Jackcdut/Graduation-project-ESP32/毕业论文/图/IMG_20251211_115416.png

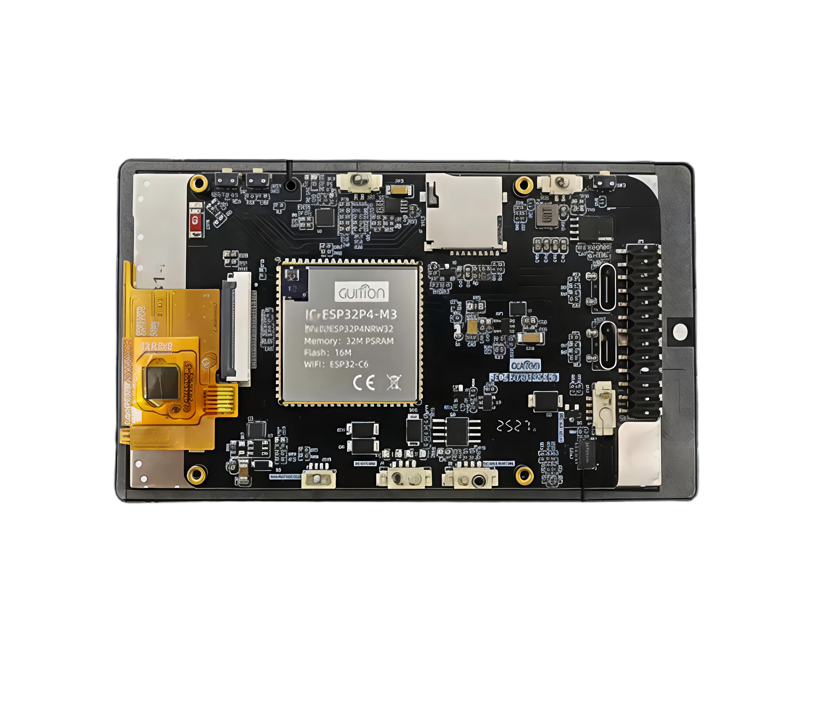
毕业论文/图/IMG_20251211_115416.png
