Jackcdut/Graduation-project-ESP32/毕业论文/图/tb_image_share_1765424619179.jpg.png

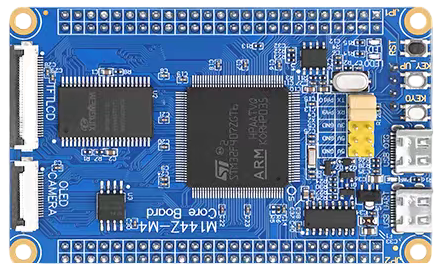
毕业论文/图/tb_image_share_1765424619179.jpg.png
