Jackcdut/Graduation-project-ESP32/毕业论文/开题/202206010320 纪帅.pdf

## 成 都 理 工 大 学

## 学生毕业设计（论文）开题报告

题目名称：面向开发调试的一体化便携测试系统设计

（中英文） Design of an Integrated Portable Testing System for Development and Debugging

题目类型：开发与设计

题目来源：教师拟定

学生姓名：纪帅 | 学生学号：202206010320 | 专业名称： 测控技术与仪器
导师姓名：司绍博 | 专业职称：研究员 | 指导人数：5

①主要研究内容、预期成果（鼓励有创新点）

### 一、 主要研究内容

本研究将遵循从系统顶层至功能模块、从硬件底层至软件应用、从本地功能至云 端协同的全栈研发路径，系统性地开展以下三个核心研究内容。

### 1.1 电路控制与信号处理（STM32 端）

本部分是整个系统的物理基础与控制核心。需要完成关键功能模块的电路与驱动 设计，实现±36V 电压的采集；基于直接数字频率合成（DDS）技术的信号发生方案， 完成 AD983x 系列芯片的外围电路设计与 SPI 驱动开发，实现 1Hz-1MHz 可编程波形 输出；研究数控开关电源原理，设计以 DAC 控制电路为核心、集成 PID 反馈的电源 模块，实现 0-12V/2A 的稳定可调输出等等。

### 1.2 数据通信与人机交互（STM32 与 ESP32）

核心在于设计一套轻量级、高可靠的通信协议。针对波形数据（数据量大、实时 性要求高）、参数指令（数据量小、要求可靠）等不同类型的信息传输需求，研究并 制定一套串行应用层协议。该协议需定义完整的帧结构（包括帧头、类型标识、长度、 数据载荷及 CRC 校验）以确保在复杂的电磁环境下数据能准确、有序地传输。在此基 础上，实现测量数据的实时图形化显示。在 ESP32 端，研究 LVGL 图形库的驱动与资 源管理，设计并实现包含波形显示区、参数读数区及虚拟控制面板的一体化用户界面。 编写专门的通信任务，实时解析来自 STM32 的协议数据包，并驱动 LVGL 的图表控 件动态刷新波形，更新数值标签等丰富完善的功能。

### 1.3 网络集成与云端服务（ESP32 端）

为系统赋予物联网能力，扩展其从本地工具到远程节点的应用边界，实现数据的 聚合与价值提升。重点实现设备与云平台的安全接入和数据上行。研究 ESP32 的 Wi-Fi 网络连接管理与中国移动 OneNet 云平台的设备接入规范。集成 MQTT 客户端，编 写网络任务，将 STM32 上传的经过预处理的数据（如波形特征值、仪表读数、设备状

态）封装为标准 JSON 格式，上传至云平台对应的数据流，完成从设备端到云端的“最 后一公里”接入。进而，开发云端数据服务与远程交互界面。同时，作为高级应用，开 发构建一个基于 HTML5 与 JavaScript 的实时数据网页。该网页通过订阅设备数据， 能够查看波形、查询历史记录、信号分析（噪声滤波，信号变换，数据导出）等功能， 初步实现系统的“端-云-端”远程协同调试能力。

### 二、 预期成果

- 功能集成测试系统平台：完成一款集示波器、信号发生器、数控直流电源、数 字万用表、无线串口五大核心功能于一体的实体设备。并设计实现包含主控、信号调 理、功率转换、接口等模块的完整电路原理图设计与四层 PCB 绘制、打样及焊接装 配，并与 ESP32-P4 核心板及 4.3 寸 MIPI 显示屏实现叠层集成。此外，完成配套外壳 的结构设计与绘制，实现系统的整体封装与便携化。
- 完整的毕业设计论文（设计报告）：系统阐述项目的背景意义、国内外现状、 详细的设计与实现过程（包括硬件电路设计、软件架构、算法原理、通信协议等）、 系统测试方法与结果分析、总结与展望。
②拟采用的研究思路（研究方法、技术路线、可行性论证）

### 三、 研究方法

### 3.1 理论基础与关键技术分析

### 3.1.1 直接数字频率合成（DDS）

在信号发生器电路中，使用 DDS 实现频率可调波形的产生。DDS（Direct Digital Frequency Synthesis，直接数字频率合成）是一种基于数字控制的信号生成技术，在通 信、雷达、仪器仪表及音频合成等领域广泛应用。其核心优势在于能够以高精度和快 速响应能力，生成频率与相位均可编程的信号。具体工作原理为：通过数字方式控制 相位累加器，从而在每个时钟周期内生成一个相位值，再通过查找表（LUT）将相位 值转换为对应的幅度值，最后通过 DAC（数模转换器）输出模拟信号。主要组成结构 见下图 3-1 所示。

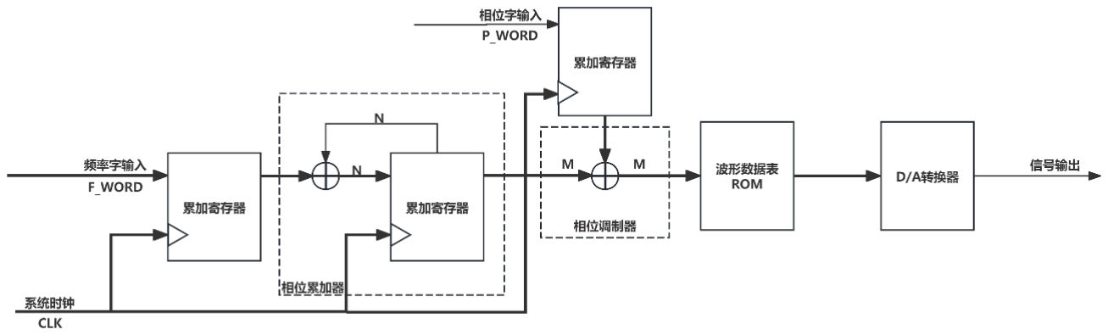
[picture p5: figure]

图 3-1 DDS 发生器基本结构框图

### 3.1.2 三重 ADC 交替采样

在示波器电路设计中，若直接采用微控制器（MCU）片内集成的模数转换器（ADC） 进行信号采样，其最高采样率通常受限于 ADC 模块自身的时钟频率与转换周期，难 以满足对高频信号的捕捉需求。为在有限的硬件成本下有效提升系统的等效采样率， 采用三重 ADC 交替采样，其原理是：当采样过程启动后，ADC1 首先执行采样操作。 经过数个 ADC 时钟周期的固定延时，ADC2 开始对同一通道进行采样，此时 ADC1 已 进入数据转换阶段。同理，在 ADC2 采样完成并再延时数个时钟周期后，ADC3 启动 采样，此时 ADC1 与 ADC2 均处于数据转换阶段。理想情况下，当 ADC3 完成采样 时，ADC1 的转换也已结束。如此，最大限度地利用硬件资源，在不提高单个 ADC 时 钟频率的前提下，将系统的整体采样吞吐量提升至近三倍。 本设计下位机部分对于信号处理使用 STM32F407ZGT6 作为控制单元，参考其数 据手册中的描述：在 ADC1、ADC2 或 ADC3 转换事件结束时，会生成三个 32 位 DMA 传输请求。之后会发生三次从 ADC_CDR 32 位寄存器到 SRAM 的传输：首先传输 ADC1 转换数据，然后是 ADC2 转换数据，最后是 ADC3 转换数据。每次出现新的三 阶段转换时都会重复这 1 一过程。当 ADC1/ADC2/ADC3 的规则通道全部完成转换后， 会生成一个 EOC 中断。整个 ADC 采样转换过程见下图 3-2 所示。

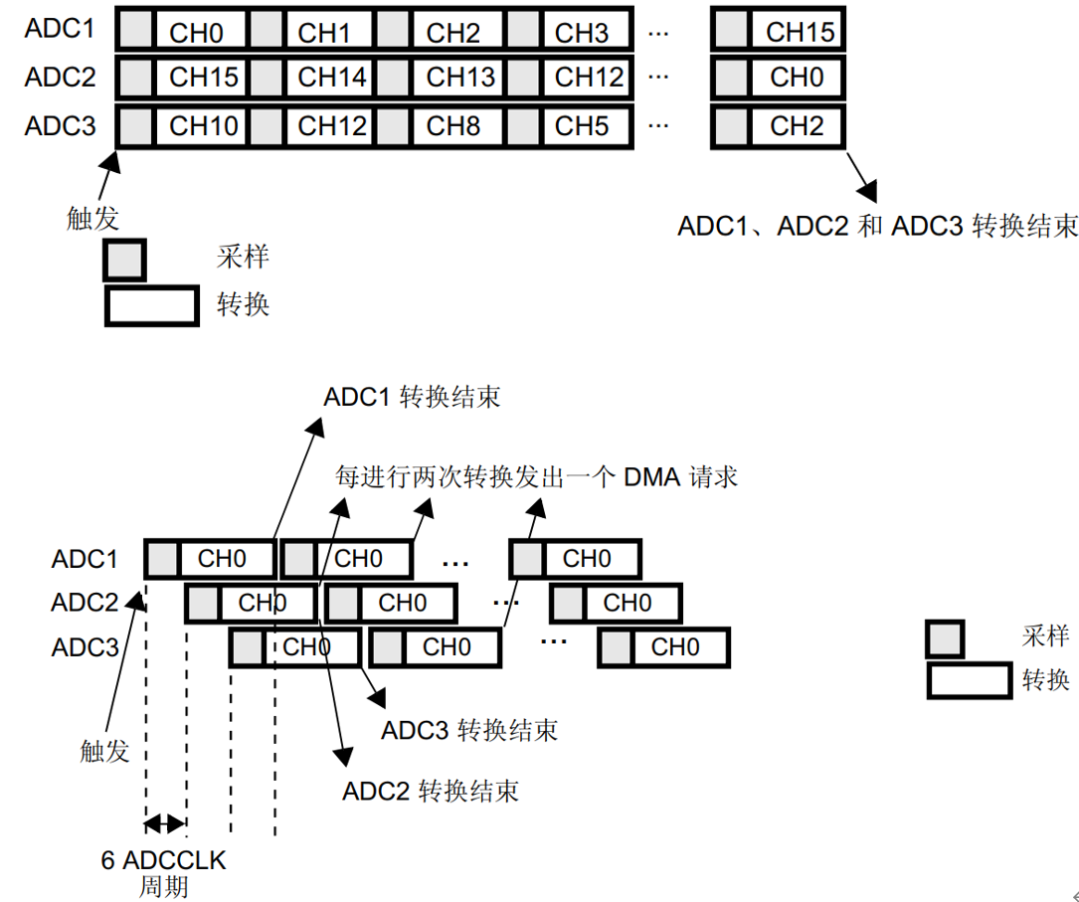
[picture p6: figure]

图 3-2 三重 ADC 模式
根据上图 3-2 可知，每当出现 2 个可用数据项时，就会生成一个 DMA 传输请求。 DMA 传输的具体顺序如下：

第 1 个请求：ADC_CDR[31:0] = ADC2_DR[15:0] | ADC1_DR[15:0]
第 2 个请求：ADC_CDR[31:0] = ADC1_DR[15:0] | ADC3_DR[15:0]
第 3 个请求：ADC_CDR[31:0] = ADC3_DR[15:0] | ADC2_DR[15:0]
第 4 个请求：ADC_CDR[31:0] = ADC2_DR[15:0] | ADC1_DR[15:0]……
因此，根据计算，ADC 完成一次转换所需的总时间Tconv 为
Tconv = Tsampling + Tconversion | (3 − 1)

采样率就是Tconv 的倒数 1

Tconv

。其中，Tsampling（采样时间）：ADC 内部采样电容对输入信号

进行充电保持所需的时间。以 ADC 时钟周期为单位，记为 SMPx 位（例如，3 周期、15 周期、

480 周期等）。时间越长，精度越高。Tconversion（转换时间）：将采样到的模拟值转换为数字值

所需的时间。对于 STM32F407ZGT6 的 12 位 ADC，固定为 12 个 ADC 时钟周期。
因此，最终采样率公式为：

fs single =

fADCCLK
SMPx + 12

(3 − 2)

以 STM32F407ZGT6 为例，ADC 最大时钟频率为 36MHz，采样时间选择最短 SMPx = 3。计算出理论最大采样率为 2.4MSPS。而通过采用三重 ADC 交替采样模式， 可使得理论最大采样率达 7.2MSPS，大大提高系统性能。

### 3.1.3 基于 DAC 与双环反馈的恒流恒压控制

在数控电源电路中，为实现对输出电压与电流的精确、稳定控制，并确保电源与 负载的安全，需在控制环路中构建独立的电压与电流双闭环反馈。通过 DAC 设定电 压与电流的参考基准，系统可依据负载实时状态在恒压与恒流模式间自动切换：当负 载电流低于设定限值时，电压环起主导作用，电源工作于恒压模式；一旦负载加重或 发生短路，电流达到设定限值，控制权自动平滑切换至电流环，电源转入恒流保护模 式。这种方式设计简洁，无需依赖传统笨重的电位器与分压网络，便于集成在系统中。 具体工作原理为：通过 DAC 设定目标值，反馈电路实时采样输出并与设定值比 较，通过误差放大器控制功率级，并由“电压环”和“电流环”两个控制环路通过“二极管 或门”或模拟开关自动竞争，实现工作模式切换。相应的工作示意图见下图 2-3 所示。

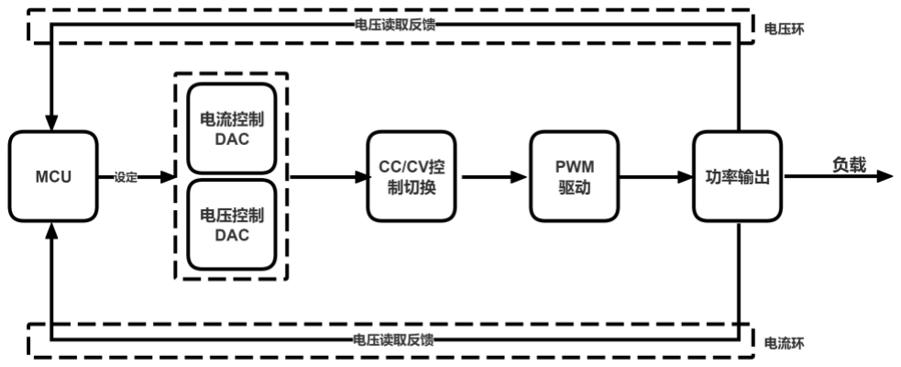
[picture p7: figure]

图 3-3 电流环与电压环反馈的恒流恒压电路框图

在恒压（CV）模式中，目标是稳定输出电压等于设定电压。反馈电压与设定电压 在电压误差放大器中进行比较。如果反馈电压小于设定电压，那么实际电压输出升高， 驱动功率级增加输出，使 反馈电压上升，直至等于设定电压，系统达到平衡。此时电 流环的状态：在纯负载（电阻）下，输出电流由设定电压和负载电阻大小决定。只要 输出电流小于设定电流，电流采样值反馈电流就小于设定电流，电流误差放大器会输 出一个很高的电压（试图拉满电流），但由于后级控制电路，会被电压环的较低输出 所“阻塞”，无法控制功率级，因此此时电流环处于“饱和”或“待命”状态。 在恒流（CC）模式中，目标是稳定输出电流等于设定电流。当负载减小时，输出 电流试图增大。一旦输出电流达到设定电流，反馈电流便等于设定电流。如果负载持 续减小，输出电流就将会超过设定电流，导致反馈电流将大于设定电流。此时，电流 误差放大器开始动作，其输出电压降低，通过后级控制电路抢过控制权，迫使功率级 降低输出电压，让输出电流精确维持在设定电流。此时电压环的状态：由于输出电压 因限流而下降，反馈电压会低于设定电压，电压误差放大器会输出一个很高的电压（试 图升压），但同样被电流环的较低输出所“阻塞”。因此此时电压环处于“饱和”或“待命” 状态。

### 3.1.4 OneNet 云平台的 HTTP API 集成

为实现一体化测试系统的远程数据管理与协同调试功能，本设计选用中国移动 OneNet 物联网云平台作为云端支撑。该平台提供设备管理、数据存储与可视化等 PaaS 服务，支持包括 HTTP、MQTT 在内的多种协议接入。 传统物联网设备接入流程通常要求用户在云端平台手动创建设备、配置鉴权信 息，步骤繁琐且影响用户体验。为此，本设计提出一种基于 HTTP 协议的设备自动注 册与接入方案。设备首次上电联网后，可自动通过 HTTP 请求完成云端注册、认证并 建立连接，实现“即用即连”的便捷体验。该方案充分利用 HTTP 协议通用性强、易于 实现文件传输（如 multipart/form-data 格式）的特点，能够直接将示波器波形、系统日 志等调试数据以文件形式上传至云端存储，为后续远程调测与分析提供便利。 HTTP 协议采用经典的“请求–响应”模型，客户端通过结构化请求指明操作与资 源，服务器返回状态信息与结果内容。基于此，本系统可通过调用 OneNet 平台开放 的 RESTful API，实现数据上报、命令接收与文件管理等功能。未来还可进一步开发 Web 前端，通过相同 API 接口获取云端数据，实现基于浏览器的远程调试与数据分 析，从而构建从设备到云再到用户端的完整数据流，提升系统的可用性与调试效率。

### 3.1.5 LVGL 图形库

LVGL（Light and Versatile Graphics Library）是一款开源的嵌入式图形用户界面 库，专为资源受限的微控制器和嵌入式系统设计。该库采用 C 语言编写，具有高度可 移植性，支持多种显示控制器和输入设备，提供丰富的 GUI 控件（如按钮、标签、图 表、滑块、列表等）和现代化的视觉效果（包括抗锯齿渲染、透明度混合、动画过渡

等）。LVGL 的内存占用可低至 64KB Flash 和 8KB RAM，同时支持硬件加速以提升 渲染性能。本项目选择 LVGL 8.3 版本作为图形界面开发框架，主要基于以下考量：

LVGL 与 ESP-IDF 开发框架深度集成，乐鑫官方提供 esp_lvgl_port 适配层，可充分利

用 ESP32-P4 的 PPA（Pixel Processing Accelerator）硬件加速单元，实现高效的图形渲 染；同时 NXP 提供的 GUI Guider 可视化设计工具支持 LVGL 界面的拖拽式开发，能 够自动生成符合规范的 C 代码，提升复杂界面的开发效率；此外，LVGL 丰富的图表 控件可直接用于示波器波形显示和数据可视化，其事件驱动机制也便于实现触摸交互 功能。本设计计划基于 LVGL 官方提供的打印机工程 Demo 进行二次开发与功能完 善。该模板的主界面已集成时间显示模块与多级菜单按钮控件，具备良好的界面布局 与交互基础，便于后续功能的拓展与定制化设计。其主界面见下图所示。

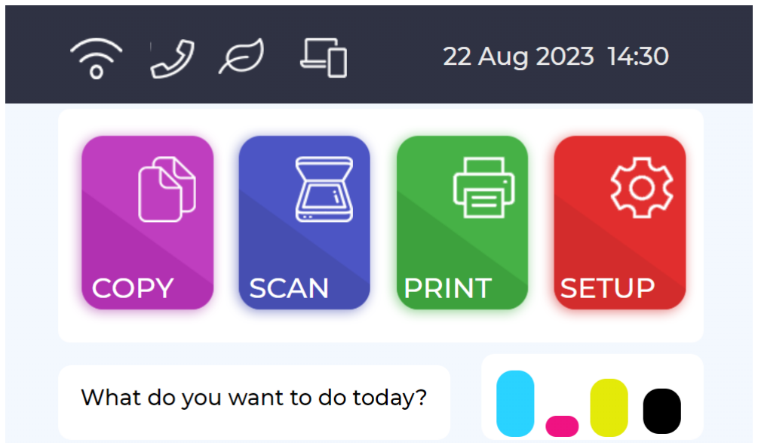
[picture p8: figure]

图 3-4 打印机 LVGL 主界面

### 3.2 研究思路与协同设计方法

总体设计遵循“功能模块化、控制集中化、交互图形化”的核心思想，构建以 ESP32-P4 与 STM32F407 双微处理器协同工作的硬件基础。其中，STM32F407 作为实时信号 处理单元，负责直接数字频率合成（DDS）波形产生、ADC 采样、数控电源反馈控制 等底层任务；ESP32-P4 则作为系统主控与交互处理器，依托其强大性能与内置无线模 块，用于运行 LVGL 图形用户界面、处理 Wi-Fi/4G 网络通信、实现与 OneNet 云平台 的数据交互。二者通过 UART 接口进行数据传输，并在 ESP32-P4 上搭载 FreeRTOS 实时操作系统，以多任务形式调度 GUI 刷新、网络通信、文件管理等顶层功能此外， 系统扩展集成 ESP32-C6 与 SD 卡模块，分别用于无线串口通信和本地数据存储，便 于调试并支持文件上传至 OneNet。预期该系统能够实现从信号发生、采集测量、电源 控制到本地显示、远程协同及数据存储等全功能一体化集成。系统的总体架构与各模 块间的逻辑关系如图 3-5 所示。

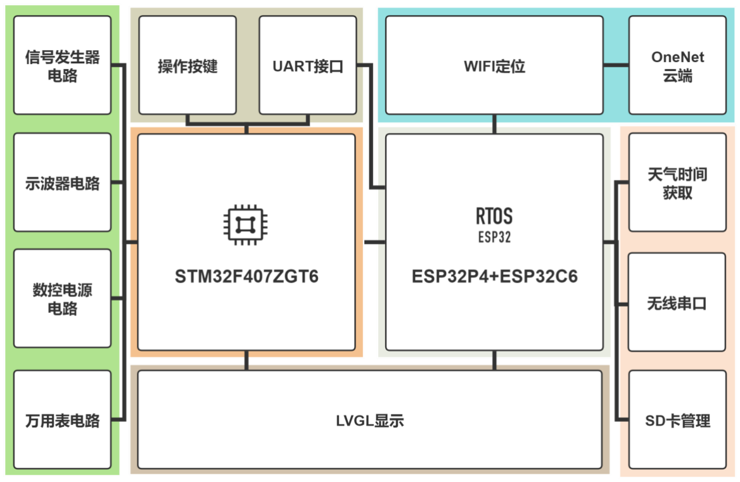
[picture p9: figure]

图 3-5 系统整体框图
在双核架构基础上，系统进一步采用 "数据驱动、功能解耦" 的设计方法构建系统 运行机制。各功能模块通过数据接口和状态机进行协同：
实时数据采集与处理路径：以示波器电路为例。示波器电路捕获的模拟信号经三 重 ADC 转换为数字数据，通过 DMA 传输至 STM32 内存区，经预处理后打包通过 UART 传送至 ESP32P4。ESP32P4 的显示任务将数据送入 LVGL 图表控件实时绘制波 形，同时网络任务可选择将数据文件通过 HTTP 协议上传至 OneNet 云端管理。 双向控制指令流：用户使用 LVGL 界面调整参数或控制命令，通过 UART 发送至 STM32F407。STM32 根据数据包内容，分别控制信号发生器的频率/幅值、数控电源 的设定输出电压/电流等，实现设备控制。
多源数据融合处理：系统集成 HTTP 天气获取、SD 卡存储等辅助功能。ESP32-C6 模块负责获取网络时间与天气数据，通过内部 SDIO 通信接口与 ESP32-P4 同步， 在 LVGL 界面统一显示；支持导出波形数据与测量结果并存储至 SD 卡，形成本地历 史记录，与云端存储构成互补的数据持久化。

### 四、 技术路线

### 4.1 总体技术路线规划

毕业设计技术路线总体规划见下图 4-1 所示。遵循“理论基础、模块验证、系统集 成、综合评估”的递进逻辑，系统展示从问题分析到方案验证的完整研究。

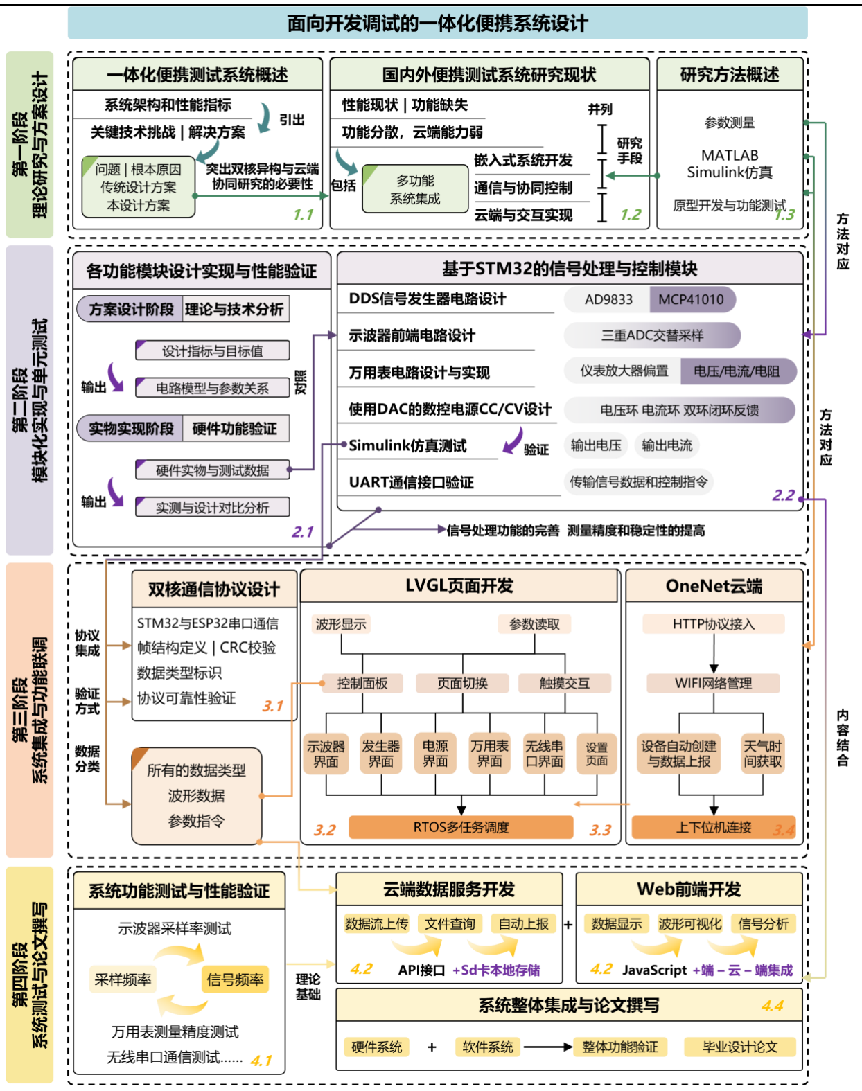
[picture p10: figure]

图 4-1 技术路线图
本设计分为四个阶段推进。第一阶段进行理论研究与方案设计，明确一体化便携 测试系统的架构与指标，分析现有问题并提出基于 STM32+ESP32 双核异构与 OneNet 云端协同的解决方案，同时调研国内外相关产品的优缺点。第二阶段开展模块化实现 与单元测试，完成硬件设计、四层 PCB 制作及核心模块（包括 DDS 信号发生器、示 波器前端、万用表电路和数控电源）的功能验证，通过仿真与测试提升测量精度与稳

定性。第三阶段实现系统集成与功能验证，设计双核通信协议，开发基于 LVGL 和 FreeRTOS 的多功能图形界面，并完成云端接入与上下位机联动。第四阶段进行系统 测试与论文撰写，验证各项性能指标，开发云端数据服务与 Web 前端，构建“端-云-端”整体架构，最终完成系统集成与毕业设计论文。

### 五、 可行性论证

### 5.1 技术可行性

### 5.1.1 理论扎实

系统设计所涉及的嵌入式软件架构、模拟/数字电路设计、信号处理算法及系统集 成等核心内容，与测控技术与仪器专业培养方案高度契合。本人已修毕《嵌入式系统 设计》、《传感器与检测技术》、《信号与系统》等核心专业课程，并取得优异成绩 （专业核心课平均成绩 88 分以上），建立扎实的理论基础。同时，通过课程设计、电 子竞赛等实践环节，积累 STM32、ESP32 等平台的开发经验，具备完成本毕业设计所 需的专业知识储备与工程实践能力。
信号发生器对应《信号与系统》、《数字信号处理》课程中的波形合成与频谱分 析理论，采用 AD9833 直接数字频率合成（DDS）技术，通过 28 位相位累加器实现 0.1Hz 的频率分辨率，结合 MCP41010 数字电位器实现幅值的程控调节，其工作原理 涉及采样定理、量化误差分析及数模转换等核心知识点，课程中对傅里叶变换、离散 时间信号处理的系统学习为理解 DDS 相位累加原理和频率合成机制奠定坚实基础。 示波器对应《模拟电子技术》、《电子测量技术》及《信号与系统》课程内容， 前端模拟信号调理电路涉及运算放大器、电压跟随器、衰减网络等模拟电路设计，负 电压产生电路采用电荷泵原理实现双电源供电，可编程增益放大通过模拟开关切换电 阻网络实现多档量程选择，这些设计直接应用课程中学习的反馈放大器、有源滤波器 及信号调理等理论知识；三重 ADC 交替采样实现 7.2MSPS 的高速数据采集，则运用 《数字信号处理》中的采样理论和抗混叠滤波原理。
万用表部分对应《传感器与检测技术》、《误差理论与数据处理》课程内容，电 压测量采用仪表放大器配合电阻分压网络实现±36V 宽量程输入，电阻测量基于电阻 分压原理通过四档 MOS 管切换实现 10Ω 至 1M 的多量程覆盖，电流测量利用精密采 样电阻将电流信号转换为电压信号进行检测，整个测量的精度分析、误差传递及校准 方法均源自课程中系统学习的测量不确定度评定和数据处理理论。 数控电源部分对应《自动控制原理》课程内容，采用恒压恒流（CV/CC）双环控 制策略应用经典控制理论中的 PI 调节器设计方法，电压外环和电流内环的参数整定、 稳定性分析及动态响应优化均基于课程中学习的频域分析和根轨迹法。 无线通信与人机交互模块的开发知识，主要来源于课外的系统性自主学习与实践 积累。作为一项四川省大学生创新训练计划项目的负责人，在主持开发“辐射探测腕

表”课题期间，本人已独立完成 LVGL 图形界面的架构设计、控件布局与交互逻辑实 现，积累嵌入式 GUI 开发的全流程经验。在此过程中，也熟练掌握借助 AI 辅助工具 进行界面原型设计、布局优化及代码生成的现代开发方法，能够高效、高质量地完成 复杂交互界面的开发任务。

### 5.1.2 系统架构可行

系统采用"STM32 实时采集处理+ESP32 应用交互显示"的双核异构架构，该架构 模式在工业测控领域已得到广泛验证和应用，能够有效平衡实时性要求与复杂应用逻 辑之间的矛盾。STM32F407 用于高速 ADC 采样、DDS 波形生成、电源环路控制等对 时序要求严格的任务，ESP32-P4 则负责 LVGL 图形界面渲染、触摸交互响应、WiFi 网络通信及云平台数据同步等应用任务。双核之间通过多路 UART 串口实现通信，每 个功能模块（示波器、信号发生器、万用表、数控电源）独立分配通信通道，避免数 据拥塞和相互干扰。通信协议采用统一的帧结构设计，包含帧头标识、命令字、数据 长度、有效载荷及 CRC 校验码，确保数据传输的完整性和可靠性。这种软硬件解耦的 分层架构使得各模块可独立开发调试，也便于后期功能扩展和维护升级。

### 5.2 开发条件可行性

项目开发所需的软硬件工具链完整齐备，开发环境成熟可靠。软件开发平台方面， STM32 端采用 Keil MDK 集成开发环境进行固件编写与调试，ESP32 端基于乐鑫官方 ESP-IDF 框架进行应用开发；电路设计采用嘉立创 EDA 完成原理图绘制与 PCB 布局 布线；系统仿真借助 MATLAB/Simulink 进行控制算法验证。上述软件工具均为现有 配置或开源免费获取，无额外成本投入。硬件测试条件方面，具备正点原子 DS100 数 字存储示波器、数控电源等测试仪器，能够满足从单元电路调试到系统级性能验证的 完整测试需求。

### 5.3 实施可行性

### 5.3.1 技术路线清晰

技术路线规划采用"四阶段"递进式研究路径：第一阶段聚焦理论研究与方案设计， 完成系统需求分析、总体架构设计及关键技术预研；第二阶段进行模块化实现与单元 测试，分别完成信号发生器、示波器、万用表、数控电源等各功能模块的硬件电路设 计与固件开发；第三阶段开展系统集成与功能验证，实现双核通信协议对接、人机交 互界面开发及云平台接入调试；第四阶段执行系统测试与论文撰写，完成性能指标测 试、可靠性验证及设计文档整理。各阶段逻辑衔接紧密、目标边界清晰，且均设置可 量化的阶段性成果输出，如设计说明书、原理图文件、测试报告等，便于进度跟踪与 质量把控。

### 5.3.2 模块化设计

系统采用模块化设计分散开发风险。硬件层面，信号发生器电路、示波器前端调 理电路、万用表测量电路、数控电源电路等各功能单元独立设计、独立供电，模块间 通过标准接口互联，单个模块的设计缺陷或调试问题不会影响其他模块的并行开发。 软件层面，采用分层架构组织代码结构，底层驱动层封装硬件操作接口，中间协议层 实现双核通信与数据解析，上层应用层负责业务逻辑与界面交互，各层职责明确、接 口规范，便于问题定位与快速迭代，同时也为后期功能扩展和性能优化预留充足空间。

### 5.4 时间可行性

### 5.4.1 时间安排合理

项目总周期规划为 16 周，与毕业设计时间安排高度匹配。工作计划已细化至周 期，各阶段任务分配均衡合理：理论研究与方案设计阶段约 3 周，模块化硬件实现与 单元测试阶段约 5 周，系统集成与功能验证阶段约 4 周，系统测试与论文撰写阶段约 4 周。关键路径聚焦于硬件电路调试和双核通信协议对接两个技术难点，已在计划中 预留充足时间用于问题排查与方案优化。同时，模块化的开发策略支持多任务并行推 进，有效缩短整体开发周期，确保系统设计能够高质量完成。

### 5.4.2 经济成本可控

系统设计遵循成本优化原则，核心物料均选用市场供应充足的通用器件。主控芯 片 STM32F407 和 ESP32-P4 为量产成熟产品，采购成本可控；功能芯片如 AD9833、 MCP41010、AD8051 等均为常规型号，单价适中且易于获取；显示屏采用标准尺寸 MIPI 接口 LCD 模组，PCB 采用常规四层板工艺制作。方案设计有意规避高端 FPGA、 专用 ASIC 等昂贵器件，通过 STM32 与 ESP32 双核协同架构在满足性能指标的前提 下实现硬件成本的有效控制。整机物料成本控制在合理预算范围内，具备良好的经济 可行性和成本优势。
③现有工作基础（毕业实习、资料收集情况及空间设备仪器条件等）

### 六、 现有工作基础

### 6.1 项目实践基础

### 6.1.1 简易数字示波器项目

在 2023 年 10 月至 11 月期间，本人独立完成简易示波器系统的开发。该系统硬 件方面完整构建模拟前端调理链路，包括交/直流耦合电路、基于运放虚短虚断原理实 现的宽范围（-1.6V~250V）信号衰减与放大电路，并设计 Type-C 供电及 XD7660 负压 生成电路，采用 GD32 单片机作为主控，搭配 1.8 寸 TFT 屏与旋转编码器实现人机交 互。软件层面实现实时波形显示、基于旋钮的时基与幅值缩放、波形暂停、幅值/频率 自动测量以及 PWM 占空比可调方波信号输出等功能。能够为本毕业设计中示波器模 块的电路设计、信号调理及交互逻辑提供技术参考与实践基础。设计的硬件原理图见

下图 6-1 所示。

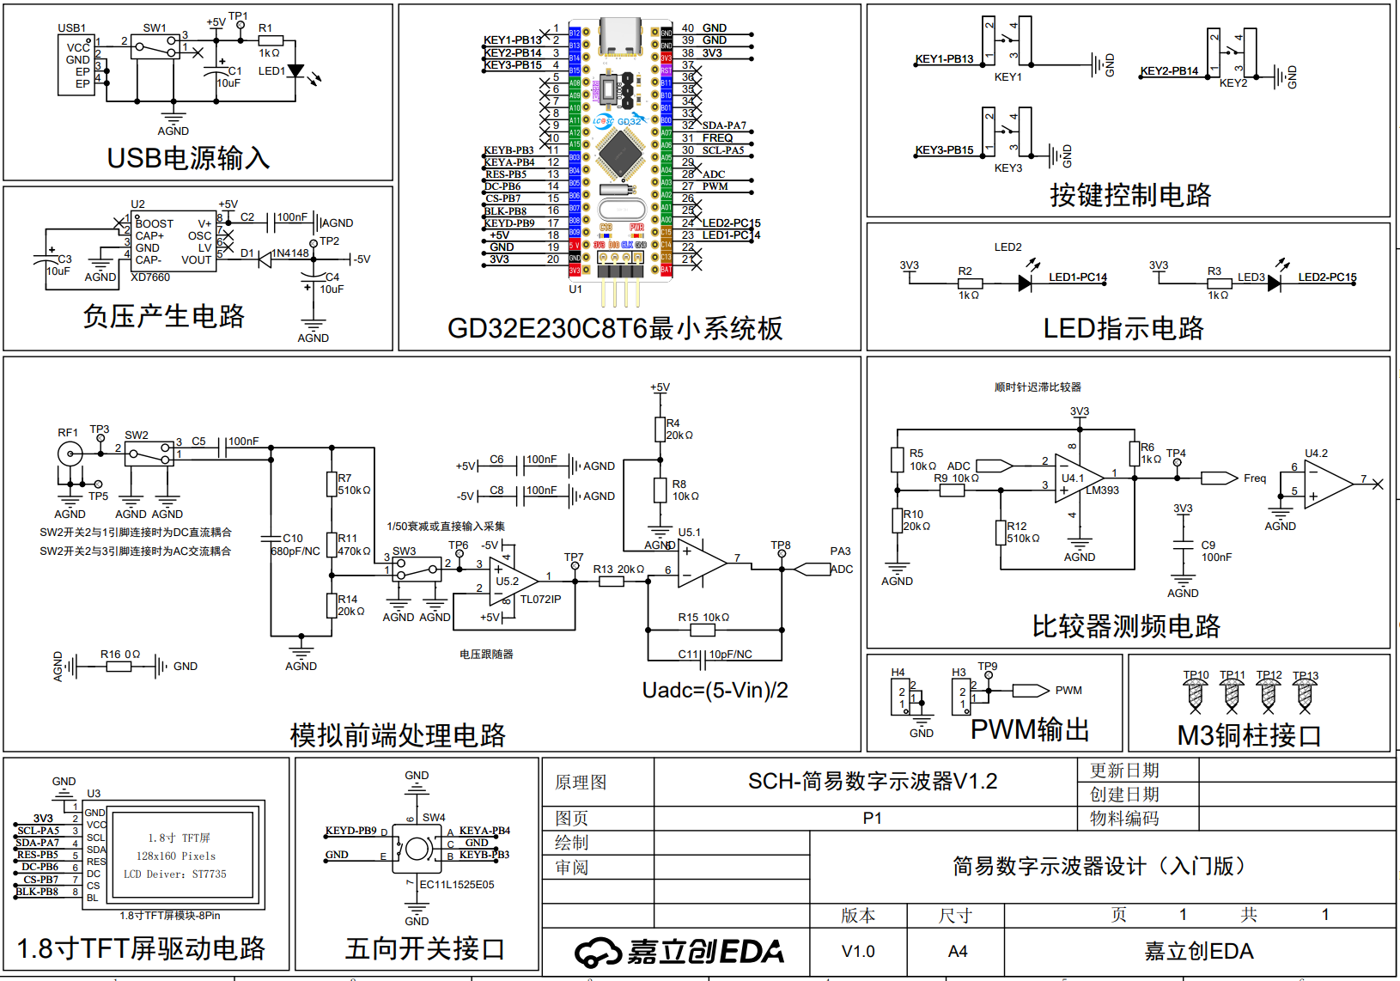
[picture p11: figure]

图 6-1 简易数字示波器项目电路原理图
分析上图中模拟前端处理电路部分，与本设计的示波器电路部分类似。两者均采 用 1MΩ 高输入阻抗以降低测量负载效应，并通过模拟开关实现 AC/DC 耦合模式的可 选切换。在信号通路中，均设计有分压衰减网络以拓展电压测量范围，并最终基于运 算放大器构成的同相/反相放大或电平移位电路，将经过衰减调理后的双极性输入信 号，转换为符合单电源 ADC 输入范围（0-3.3V）的单极性电压信号。

### 6.1.2 四川省大学生创新训练计划项目

2024 年 3 月，本人作为项目负责人成功申报四川省大学生创新训练计划项目。该 项目针对核辐射应急监测场景，设计一款集辐射检测、智能报警、无线通信与定位功 能于一体的可穿戴设备。系统核心采用碘化铯（CsI）闪烁晶体作为辐射探测器，当γ 射线或 X 射线入射时晶体产生闪烁荧光，通过内置光电传感器将光信号转换为电信 号，经信号调理与数字化处理后推算出辐射剂量率，并与预设阈值比较实现超限报警 功能。报警触发时系统自动启动 4G 无线通信模块将报警信息、辐射剂量数据实时上 传至云服务器，同时开启北斗 GNSS 卫星定位与基站辅助定位双模定位功能，精确获 取设备地理位置信息，便于应急响应与人员追踪。
作为项目负责人，本人主导系统的软硬件设计与开发工作。硬件设计方面，完成 原理图绘制与 PCB 布局，主要包括：4G 通信模块接口电路、锂电池电源管理电路、 前置放大与整形电路、主控系统电路、OLED 显示屏与按键的人机交互接口电路、振

动马达驱动电路以及腕表开关机与低功耗管理电路等。软件开发方面，完成嵌入式固 件的核心功能模块编写，包括：Flash 存储器的数据读写与磨损均衡管理、辐射剂量超 阈值的多级报警逻辑、闪烁脉冲信号的数字滤波与剂量率转换算法、基于 LVGL 图形 库的腕表界面交互设计等。该项目的完整实践经历使本人系统掌握便携式电子设备从 需求分析、方案设计、硬件开发、软件编程到系统调试的全流程开发能力，尤其在低 功耗设计、无线通信集成、嵌入式 GUI 开发等方面积累宝贵经验，为本毕业设计中 ESP32 平台应用开发、云平台数据通信及 LVGL 人机界面设计奠定坚实的技术基础。 图 6-2 是关于本项目的部分相关成果。

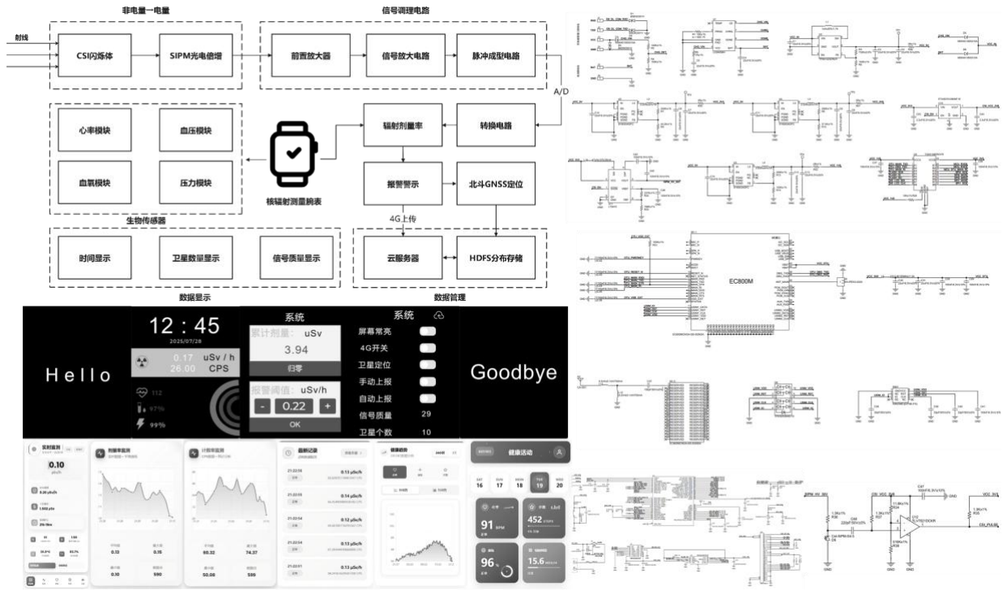
[picture p12: figure]

图 6-2 四川省大学生创新训练计划项目部分成果

### 6.2 资料收集情况

为确保毕业设计顺利开展，本人已系统收集并整理与课题相关的技术文献、数据 手册及开发资源，形成较为完备的资料库。

### 6.2.1 核心器件技术文档

已收集本设计所涉及全部核心芯片的官方数据手册及应用指南，包括： STM32F407 系列微控制器参考手册、编程手册及 HAL 库用户手册；ESP32-P4 技术参 考手册、ESP-IDF 编程指南及 ESP-Hosted 协议文档；AD9833 直接数字频率合成器数 据手册及 DDS 应用笔记；MCP41010 数字电位器数据手册；AD8051 高速运算放大器 数据手册及典型应用电路；TLV3501 高速比较器技术文档；AO3401 P 沟道 MOS 管参 数规格书；SGM3204 电荷泵芯片应用手册等。

### 6.2.2 学术文献

通过中国知网、万方数据、IEEE Xplore 等学术数据库，检索并研读数十篇与课题

相关的学术论文和学位论文，包括便携式测试仪器设计、DDS 信号发生技术嵌入式 GUI 设计、物联网云平台接入等研究方向。

### 6.2.3 开发平台与开源资源

已完成开发环境的搭建与配置，包括 Keil MDK v5 开发环境及 STM32F4 固件库、

ESP-IDF v5.x 开发框架及工具链、嘉立创 EDA 专业版电路设计软件、MATLAB R2022b 仿真平台等。同时收集整理 LVGL 图形库官方文档及示例工程、FreeRTOS 的 API 手 册、OneNet 物联网平台 HTTP 接入开发指南及 API 文档、cJSON 轻量级解析库等开 源资源。此外，通过 GitHub、CSDN 等技术社区积累大量 STM32 多通道 ADC 采样、 ESP32 WiFi 应用、LVGL 界面开发等方面的参考代码和实践案例，为软件开发提供丰 富的借鉴素材。

### 6.2.4 个人学习情况

为夯实嵌入式开发技术基础，本人系统学习过正点原子 STM32 开发教程，并基 于 HAL 库完成全套例程的实践操作。学习内容覆盖 STM32 微控制器的核心外设与典 型应用，包括：GPIO 控制与矩阵键盘扫描、外部中断与按键检测、UART 串口通信、 独立看门狗（IWDG）与窗口看门狗（WWDG）、基本定时器与通用定时器应用、PWM 波形输出与占空比调节、输入捕获与频率测量、脉冲计数、高级定时器及其互补输出 与死区控制、ADC 模数转换、DMA 数据传输、SPI/I2C 总线通信等。通过逐一完成上 述例程的代码编写、编译调试与功能验证，深入理解 STM32 外设的工作原理和 HAL 库的编程方法，积累数十个可复用的工程模板，这些学习成果将直接服务于本毕业设 计。系统化的例程学习使本人具备快速开发 STM32 应用程序的能力，为毕业设计的 顺利实施提供坚实的技术储备。

④主要参考文献目录及文献综述

### 七、 文献综述

便携式数字示波器作为电子测量领域的重要工具，其设计方法和实现技术一直是 研究热点。狄飞[1]设计一种基于 FPGA 与 STM32 的手持式数字示波器，采用 FPGA 进 行高速信号采集与预处理，STM32 负责人机交互与系统控制，实现硬件资源的合理分 配与功能协同，为便携式示波器的双芯片架构设计提供参考方案。徐建清等[2]针对多 通道信号采集需求，设计基于 ZYNQ 异构平台的便携式多通道采集系统，利用 ZYNQ 芯片 ARM+FPGA 的架构优势，实现多通道信号的同步采集与实时处理，验证异构计 算平台在便携式测量仪器中的应用可行性。张浩博[9]针对高精度测量需求，设计并实 现四通道高精度数字万用表，研究多通道测量的精度保证与通道间隔离技术，为本设 计中万用表模块的多量程测量提供技术借鉴。
直接数字频率合成（DDS）技术因其频率分辨率高、切换速度快、相位连续等优 点，在信号发生器设计中得到广泛应用。张雅珍等[3]设计基于 AD9833 的信号发生器，

分析 AD9833 芯片的工作原理与 SPI 通信时序，实现正弦波、三角波、方波等多种波 形的可编程输出，为本设计中信号发生器模块的芯片选型与驱动开发提供直接参考。 沈辉等[4]研究基于 DDS 技术的信号发生器设计，针对 DDS 输出信号的杂散与谐波问 题，提出滤波与补偿方案，分析频率调谐字与输出频率的数学关系，为理解 DDS 相位 累加原理和实现高精度频率控制奠定理论基础。
高速数据采集与稳定电源输出是测试系统的核心功能。屠晓伟等[5]设计基于 STM32 和 USB 的多通道数据采集系统，研究 STM32 内置 ADC 的多通道采样配置与 DMA 传输优化方法，实现高效的数据采集与传输，其 ADC 配置与数据处理方法可直 接应用于本设计的示波器采样模块。柳彦钊[6]研究基于 STM32 的数控开关电源设计， 采用 DAC 设定参考电压、ADC 采样反馈电压的闭环控制架构，实现输出电压的精确 可调，并分析恒压恒流（CV/CC）模式切换的控制策略，为本设计中数控电源模块的 双环反馈控制提供重要的理论与实践参考。
物联网技术的发展为测量仪器的网络化升级提供新的途径。张睿翔[8]设计并实现 基于 OneNET 的物联网设备管理系统，研究设备接入认证、数据上报格式、云端数据 存储与可视化等关键技术，为本设计中 OneNet 云平台的 HTTP 接入方案提供系统性 参考。丁依等[7]设计基于 ESP32 嵌入式 Web 服务器的手机化仪表，利用 ESP32 的 WiFi 功能构建本地 Web 服务器，实现通过手机浏览器访问仪表数据的功能，验证 ESP32 平 台在仪器网络化应用中的可行性。Zhenglin J 等[13]研究基于 STM32 和 OneNet 物联网 平台的气象监测系统，详细阐述 STM32 与 OneNet 平台的数据通信协议与接口实现方 法。Lin J 等[15]设计基于 OneNET 平台的智能环境监测系统，研究传感器数据采集、云 端上传与远程监控的完整技术链路，为本设计的云端数据管理功能提供应用案例参 考。
随着物联网与人工智能技术的快速发展，仪器仪表正朝着网络化、数字化、智能 化方向演进。田英明等[10]系统分析自动化仪表网络化、数字化、智能化的发展趋势与 实践路径，指出多功能集成、云端互联、智能分析是未来仪表发展的重要方向，为本 设计的系统架构规划提供宏观指导。Bustomi A M 等[11]研究基于 ESP32 的智能温室物 联网系统，实现环境参数的自动监测与控制，验证 ESP32 在复杂物联网应用中的稳定 性与可靠性。Almeida A D 等[12]研究基于 ESP32 的无网关 LoRa Mesh 网络设计，提出 自愈机制并进行性能评估，展示 ESP32 平台在无线通信领域的扩展应用能力。 综上所述，国内外学者在便携式测量仪器、DDS 信号发生、高速数据采集、数控 电源设计及物联网云平台接入等方面已开展大量研究工作，取得丰硕成果。然而，现 有研究多聚焦于单一功能模块的设计与优化，缺乏面向嵌入式开发调试全流程的多功 能集成方案。本设计拟在现有研究基础上，采用 STM32+ESP32 双核异构架构，集成 示波器、信号发生器、数控电源、万用表及无线串口五大功能，并实现与 OneNet 云平 台的深度对接，为开发调试场景提供一体化便携测试解决方案。

### 参考文献

[1] 狄飞.基于 FPGA 与 STM32 的手持式数字示波器设计[D].西南科技大学,2018.
[2] 徐建清,吴长瑞,蒋景红.基于 ZYNQ 的便携式多通道采集系统设计与实现[C]//中国声学学

会.2019 年全国声学大会论文集.中国科学院先进水下信息技术重点实验室中国科学院声学研究

所;,2019:237-238.

[3] 张雅珍,魏榕山.基于 AD9833 的信号发生器设计与实现[J].中国仪器仪表,2010,(03):60-62+70.
[4] 沈辉,薛兵,唐朝阳,等.基于 DDS 技术的信号发生器设计[J].电子测量技术,2020,43(20):160-

164.DOI:10.19651/j.cnki.emt.2004758.
[5] 屠晓伟,俞润超,杨庆华.基于 STM32 和 USB 的多通道数据采集系统设计与实现[J].自动化仪

表,2020,41(05):84-87.DOI:10.16086/j.cnki.issn1000-0380.2019070042.

[6] 柳彦钊.基于 STM32 的数控开关电源设计[D].西安科技大学,2019.
[7] 丁依,何岭松.基于 ESP32 嵌入式 Web 服务器的手机化仪表设计[J].电子技术应用, 2025,51(11):

107-115.DOI:10.16157/j.issn.0258-7998.256290.
[8] 张睿翔 . 基于 OneNET 的 物 联 网 设 备 管 理 系 统 设 计 与 实 现 [D]. 重庆邮电大

学,2018.DOI:10.27675/d.cnki.gcydx.2018.000295.

[9] 张浩博 . 四 通 道 高 精 度 数 字 万 用 表 设 计 与 实 现 [D]. 电 子 科 技 大

学,2025.DOI:10.27005/d.cnki.gdzku.2025.001637.

[10] 田英明,高帆,杨志敏.自动化仪表网络化、数字化、智能化的探索与实践[J].自动化仪

表,2025,46(11):106-113.DOI:10.16086/j.cnki.issn1000-0380.2025070235.

[11] Bustomi A M ,Riauwindu Q ,Suhiyar I A , et al. Smart greenhouse based ESP32 with IoT system for

automatic monitoring and control[J].Journal of Physics: Conference Series,2025,3132(1):012007-

012007.DOI:10.1088/1742-6596/3132/1/012007.

[12] Almeida A D ,Altamirano C J ,Cañizares R M , et al. Gateway-Free LoRa Mesh on ESP32: Design,
Self-Healing | Mechanisms, | and | Empirical | Performance.[J].Sensors | (Basel,

Switzerland),2025,25(19):6036-6036.DOI:10.3390/S25196036.

[13] Zhenglin J ,Ren B . Weather monitoring system based on STM32 and OneNet Internet of Things
platform[J].Journal | of | Physics: | Conference | Series,2021,1820(1):012150-.DOI:10.1088/1742-

6596/1820/1/012150.

[14] Design and Research of Infusion Monitoring System Based on OneNET Platform[J].2020,440(5):

[15]Lin J ,Yuping M . Design and implementation of intelligent environment monitoring system based on

OneNET platform[J].E3S Web of Conferences,2020,16502018.DOI:10.1051/e3sconf/202016502018.

⑤工作计划

起止日期 | 主要任务 | 工作地点 | 检查方式
2026 年 2 月 21 日-2026 年 3 月 1 日 | 选题 | 学校 | 现场
2026 年 3 月 1 日-2026 年 3 月 15 日 | 资料收集，预研 | 学校 | 现场
2026 年 3 月 15 日-2026 年 3 月 31 日 | 开题报告 | 学校 | 现场
2026 年 4 月 1 日-2026 年 5 月 25 日 | 开展研究，撰写论 文 | 学校 | 现场
2026 年 5 月 25 日-2026 年 5 月 31 日 | 完成修改，定稿 | 学校 | 现场
2026 年 6 月 1 日-2026 年 6 月 5 日 | 答辩 | 学校 | 现场

⑥指导教师或指导小组评价（题目、工作要点、方法、进度及准备情况）：

指导教师（签名）： | 年 | 月 | 日

⑦对学生开题报告的评审意见（是否同意进入毕业论文或毕业设计撰写阶段）：

教学系主任（签字）： | 年 | 月 | 日
