Jackcdut/Graduation-project-ESP32/毕业论文/README.md

# 📚 毕业论文资料

本目录包含毕业设计论文相关的所有文档资料。

## 📁 目录结构

```
毕业论文/
├── 开题/           # 开题报告相关文档
├── 文献翻译/       # 外文文献翻译
├── 参考文献/       # 参考论文PDF
└── 图/             # 论文中使用的图片
```

## 📄 文件说明

### 开题报告
- `202206010320 纪帅.docx` - 开题报告
- `文献综述.doc` - 文献综述报告
- `综合实习.docx` - 综合实习报告

### 文献翻译
- `外文翻译 纪帅.doc` - 外文文献翻译

### 参考文献
包含与本设计相关的参考论文：
- 基于AD9833的信号发生器设计
- 基于ESP32嵌入式Web服务器设计
- 基于STM32的数字示波器设计
- 多通道数据采集系统设计
