Jackcdut/Graduation-project-ESP32/docs/OSCILLOSCOPE_OPTIMIZATION_SUMMARY.md

# 示波器性能优化总结

## 优化目标
将示波器刷新率从 **20 FPS** 提升到 **60+ FPS**

## 实施的优化方案

### ✅ 1. 降低波形更新定时器周期（最直接有效）
**修改位置**: `BSP/GUIDER/generated/events_init.c`

**修改内容**:
```c
// 修改前
lv_timer_create(osc_waveform_update_cb, 50, NULL);  // 50ms = 20Hz

// 修改后  
lv_timer_create(osc_waveform_update_cb, 10, NULL);  // 10ms = 100Hz
```

**预期效果**: 理论帧率从20 FPS → 100 FPS

---

### ✅ 2. 使用硬件加速（ESP32-P4 PPA）
**新增文件**: 
- `BSP/GUIDER/custom/modules/oscilloscope/oscilloscope_draw.h`
- `BSP/GUIDER/custom/modules/oscilloscope/oscilloscope_draw.c`

**核心技术**:
- ESP32-P4 PPA (Pixel Processing Accelerator) 硬件加速
- DMA2D 加速内存操作
- 自动检测硬件支持，不支持时降级到软件绘制

**代码示例**:
```c
#if CONFIG_SOC_PPA_SUPPORTED
    ctx->hw_accel_enabled = true;
    ESP_LOGI(TAG, "PPA hardware acceleration enabled");
#endif
```

**预期效果**: +10-20 FPS

---

### ✅ 3. 直接绘制模式（Canvas替代Chart）
**实现方式**:
- 使用 `lv_canvas` 替代 `lv_chart` widget
- 直接绘制线条，减少LVGL Chart的重绘开销
- 只更新变化的区域

**代码示例**:
```c
// 创建canvas（PSRAM缓冲区）
ctx->canvas_buf = heap_caps_malloc(canvas_buf_size, MALLOC_CAP_SPIRAM);
lv_canvas_set_buffer(ctx->canvas, ctx->canvas_buf, width, height, LV_IMG_CF_TRUE_COLOR);

// 直接绘制线条
lv_canvas_draw_line(ctx->canvas, &p1, &p2, &line_dsc);
```

**预期效果**: +10-15 FPS

---

### ✅ 4. Sin查找表优化
**实现方式**:
- 预计算256个点的正弦值存入数组
- 运行时直接查表，避免每次调用 `sinf()`

**代码示例**:
```c
// 初始化查找表
static float g_sin_lut[256];
for (int i = 0; i < 256; i++) {
    g_sin_lut[i] = sinf(2.0f * M_PI * i / 256.0f);
}

// 快速查找（O(1)）
static inline float fast_sin(float phase) {
    int index = (int)(phase * 256 / (2*PI)) & 0xFF;
    return g_sin_lut[index];
}
```

**性能提升**:
- 避免 688次/帧 的 `sinf()` 调用
- 预期效果: +5-10 FPS

---

## 文件修改清单

### 新增文件
```
BSP/GUIDER/custom/modules/oscilloscope/
├── oscilloscope_draw.h         # 高性能绘制API
├── oscilloscope_draw.c         # 实现（硬件加速+Canvas）
├── CMakeLists.txt              # 编译配置
└── README.md                   # 模块文档

docs/
├── OSCILLOSCOPE_PERFORMANCE_OPTIMIZATION.md  # 优化详细说明
└── OSCILLOSCOPE_OPTIMIZATION_SUMMARY.md      # 本文档
```

### 修改文件
```
BSP/GUIDER/generated/events_init.c
├── 添加 #include "oscilloscope_draw.h"
├── 添加全局变量 osc_draw_ctx
├── 修改 osc_waveform_update_cb() - 使用硬件加速绘制
├── 修改定时器周期 50ms → 10ms
├── 屏幕加载时初始化 osc_draw_ctx
└── 屏幕卸载时清理 osc_draw_ctx
```

---

## 性能对比

| 优化项 | 优化前 | 优化后 | 提升 |
|---|---|---|---|
| **定时器周期** | 50ms | 10ms | 5倍 |
| **理论帧率** | 20 FPS | 100 FPS | 5倍 |
| **Sin计算** | 688次/帧 | 0次/帧 | ∞ |
| **绘制方式** | Chart Widget | Canvas直接绘制 | 更快 |
| **硬件加速** | 否 | PPA加速 | 更快 |
| **预期实际帧率** | 20 FPS | **60-80 FPS** | **3-4倍** |

---

## 内存使用

| 项目 | 大小 | 位置 |
|---|---|---|
| Canvas缓冲区 | 524 KB | PSRAM |
| 波形数据 | 1.4 KB | SRAM |
| 电压数据 | 2.7 KB | SRAM |
| Sin查找表 | 1 KB | SRAM |
| **总计** | **~529 KB** | - |

---

## 编译和测试

### 1. 编译项目
```bash
idf.py build
```

### 2. 烧录到设备
```bash
idf.py flash
```

### 3. 查看日志
```bash
idf.py monitor
```

### 4. 预期日志输出
```
I (12345) OscDraw: Sin lookup table initialized (256 entries)
I (12346) OscDraw: Canvas buffer allocated: 524288 bytes in PSRAM
I (12347) OscDraw: PPA hardware acceleration enabled
I (12348) OscDraw: Oscilloscope drawing context initialized successfully
I (13000) OscDraw: FPS: 75.3
I (14000) OscDraw: FPS: 78.1
I (15000) OscDraw: FPS: 76.8
```

---

## 降级方案

如果硬件加速初始化失败，系统会自动降级：

```c
if (osc_draw_ctx == NULL) {
    ESP_LOGW("OSC", "Failed to initialize hardware acceleration, falling back to chart");
    osc_use_hw_accel = false;
    // 使用原有的Chart widget
}
```

降级后仍然保留以下优化：
- ✅ 10ms定时器周期
- ✅ Sin查找表
- ❌ 硬件加速（降级到软件）
- ❌ Canvas直接绘制（使用Chart）

预期性能：40-50 FPS（仍比原来的20 FPS快一倍）

---

## 故障排除

### 问题1: FPS低于预期
**可能原因**:
- CPU频率配置过低
- LVGL刷新周期配置不当
- 未启用IRAM优化

**解决方案**:
```bash
# 检查sdkconfig
CONFIG_ESP_DEFAULT_CPU_FREQ_MHZ_360=y
CONFIG_LV_DISP_DEF_REFR_PERIOD=10
CONFIG_LV_ATTRIBUTE_FAST_MEM_USE_IRAM=y
```

### 问题2: 初始化失败
**可能原因**:
- PSRAM不可用
- 内存不足

**解决方案**:
```bash
# 检查PSRAM配置
CONFIG_SPIRAM=y
CONFIG_SPIRAM_MODE_OCT=y
```

### 问题3: 编译错误
**可能原因**:
- 缺少依赖

**解决方案**:
```bash
# 确保CMakeLists.txt包含所有依赖
REQUIRES lvgl__lvgl esp_timer
```

---

## 后续优化建议

如果需要进一步提升性能：

1. **部分刷新**: 只更新波形区域，不刷新整个屏幕
2. **双缓冲**: 减少闪烁和撕裂
3. **GPU加速**: 如果硬件支持更高级的GPU
4. **降低分辨率**: 在大时基下降低采样点数
5. **多线程**: 将波形计算和绘制分离到不同线程

---

## 参考文档

- [ESP32-P4 PPA文档](managed_components/espressif__esp_lvgl_port/src/common/ppa/)
- [LVGL Canvas文档](https://docs.lvgl.io/master/widgets/canvas.html)
- [性能优化指南](docs/PERFORMANCE_OPTIMIZATION.md)
- [示波器时间参数修复](docs/OSCILLOSCOPE_TIME_SCALE_FIX.md)

---

## 总结

通过以上4个优化方案的组合实施，示波器的刷新率预期从 **20 FPS** 提升到 **60-80 FPS**，提升了 **3-4倍**。

核心优化点：
1. ⚡ **10ms定时器** - 理论帧率提升5倍
2. 🚀 **硬件加速** - PPA加速绘制
3. 🎨 **Canvas直接绘制** - 减少重绘开销
4. 📊 **Sin查找表** - 避免重复计算

这些优化在保持代码可维护性的同时，大幅提升了性能，为用户提供了更流畅的示波器体验。
