Jackcdut/Graduation-project-ESP32/信息文档/信号发生器.docx

信号发生器

该部分使用STM32+DDS形式输出。DDS芯片为AD9833。

这里需要说明一下，AD9833的输出波形频率，最高可达12.5MHz。这个12.5MHz是怎么来的呢？

因为AD9833的输入时钟频率最高是25MHz，由于奈奎斯特采样定律的限制，输出波形的每个周期内至少要2个点才能还原出信号，所以，25MHz/2 = 12.5MHz，是这么来的。

但是，这里要特别注意一下，奈奎斯特采样定理使用的条件，它描述的是波形中所含正弦波的最高频率。

因此，如果我们想让它输出12.5MHz的正弦波是可行的，一个周期内两个点的波形，再加上后端的低通滤波器就能实现；输出方波也是可行的，因为方波只有高、低电平的变化，输出不加任何滤波就是方波；而想要输出三角波，就不可能了，一个周期中只输出两个点，怎么都不可能形成三角波的图形，要想输出三角波，只能降低频率，让一个周期内的点数增加，才能输出类似三角波的波形。

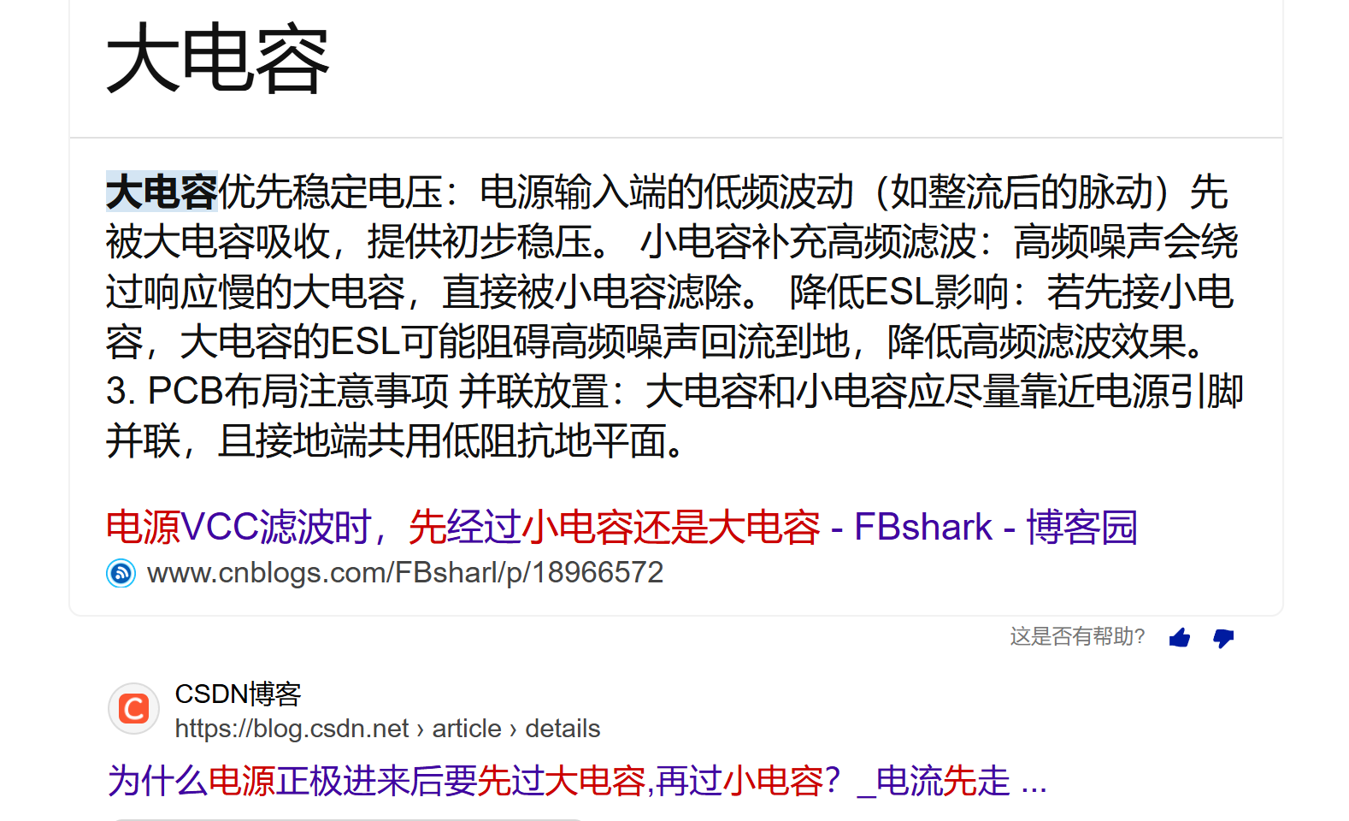
[picture p14: figure]
