Jackcdut/Graduation-project-ESP32/毕业论文/图/技术路线图.pptx

面向开发调试的一体化便携系统设计

第一阶段
理论研究与方案设计

一体化便携测试系统概述

系统架构和性能指标

关键技术挑战 | 解决方案

突出双核异构与云端协同研究的必要性

问题 | 根本原因
传统设计方案
本设计方案

引出

国内外便携测试系统研究现状

性能现状 | 功能缺失

功能分散，云端能力弱

嵌入式系统开发

多功能
系统集成

通信与协同控制

并列

研究手段

1.2

研究方法概述

参数测量
MATLAB
Simulink仿真
原型开发与功能测试

1.1

包括

云端与交互实现

1.3

方法对应

基于STM32的信号处理与控制模块

仪表放大器偏置

电压/电流/电阻

使用DAC的数控电源CC/CV设计

UART通信接口验证

信号处理功能的完善 测量精度和稳定性的提高

各功能模块设计实现与性能验证

方案设计阶段

理论与技术分析

设计指标与目标值

电路模型与参数关系

实物实现阶段

硬件功能验证

硬件实物与测试数据

对照

2.1

DDS信号发生器电路设计

示波器前端电路设计

AD9833

MCP41010

三重ADC交替采样

第二阶段
模块化实现与单元测试

输出

实测与设计对比分析

双核通信协议设计

STM32与ESP32串口通信
帧结构定义 | CRC校验
数据类型标识
协议可靠性验证

所有的数据类型
波形数据
参数指令

Simulink仿真测试

万用表电路设计与实现

验证

电压环 电流环 双环闭环反馈

输出电压

输出电流

方法对应

输出

传输信号数据和控制指令

2.2

协议集成

LVGL页面开发

RTOS多任务调度

波形显示

参数读取

OneNet云端

HTTP协议接入

WIFI网络管理

设备自动创建与数据上报

上下位机连接

第三阶段
系统集成与功能联调

验证方式

数据分类

3.1

控制面板

发生器界面

示波器界面

3.2

电源
界面

页面切换

万用表界面

无线串口界面

触摸交互

设置
页面

天气时间获取

3.4

内容结合

3.3

第四阶段
系统测试与论文撰写

系统整体集成与论文撰写

系统功能测试与性能验证

示波器采样率测试

万用表测量精度测试
无线串口通信测试……

云端数据服务开发

自动上报

+Sd卡本地存储

软件系统

数据流上传

4.2

硬件系统

文件查询

API接口

+

Web前端开发

信号分析

+端 – 云 – 端集成

4.4

毕业设计论文

数据显示

4.2

波形可视化

JavaScript

整体功能验证

采样频率

信号频率

4.1

理论基础

+
