Jackcdut/Graduation-project-ESP32/毕业论文/图/PixPin_2025-12-11_10-40-59.png

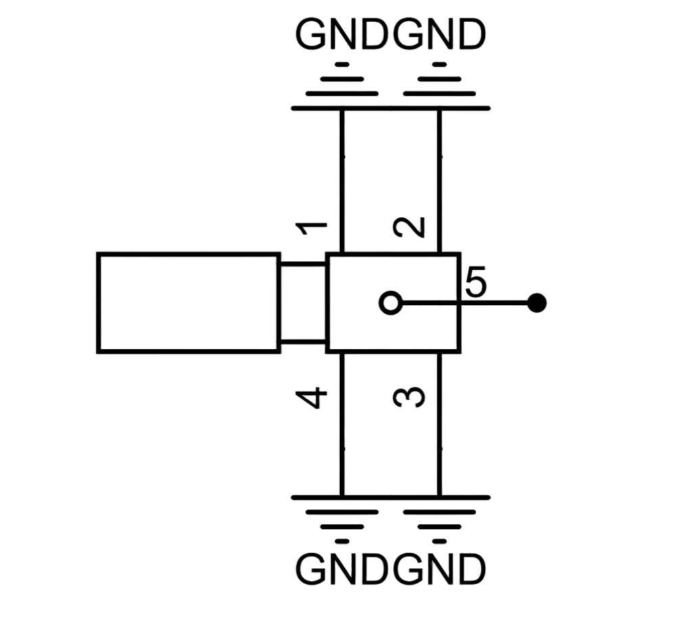
毕业论文/图/PixPin_2025-12-11_10-40-59.png
