Jackcdut/Graduation-project-ESP32/毕业论文/图/图片1.png

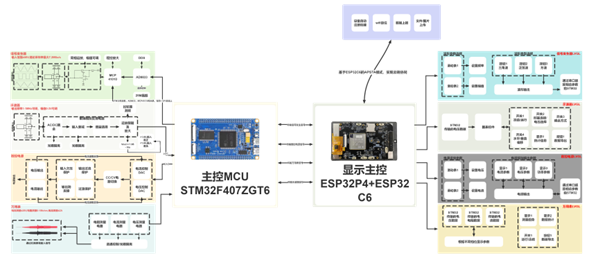
毕业论文/图/图片1.png
