Jackcdut/Graduation-project-ESP32/软件设计/Photo/SHOT0001.BMP

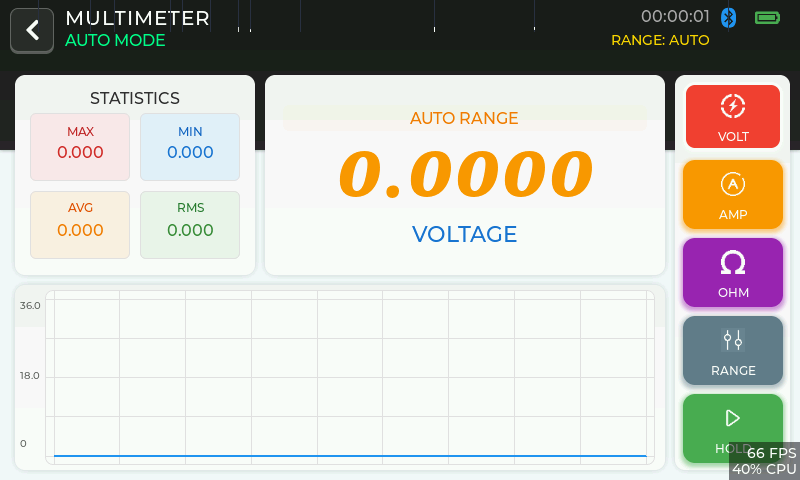
软件设计/Photo/SHOT0001.BMP
