Jackcdut/Graduation-project-ESP32/docs/OSCILLOSCOPE_COMPILE_FIX.md

# 示波器优化编译修复指南

## 问题1: lv_point_t初始化语法错误

### 错误描述
C99标准不支持 `lv_point_t p = {x, y}` 的简写语法

### 解决方案
使用指定初始化器：`lv_point_t p = {.x = x, .y = y}`

### 已修复文件
- `BSP/GUIDER/custom/modules/oscilloscope/oscilloscope_draw.c`

---

## 问题2: 返回按钮无响应

### 可能原因
1. Canvas覆盖了按钮区域
2. 事件传播被阻止
3. Z-order问题

### 解决方案
确保Canvas只在波形容器内部，不影响其他UI元素：
- Canvas位置: `scrOscilloscope_contWaveform` 内的 (2, 2)
- 返回按钮位置: 屏幕上的 (4, 0)
- 两者不重叠

### 调试步骤
1. 检查Canvas的父对象是否正确
2. 确认Canvas大小不超出容器
3. 验证返回按钮的事件回调已注册

---

## 问题3: 右侧按钮向下移动

### 原因
可能是布局计算问题或CSS样式冲突

### 检查项
1. 查看 `setup_scr_scrOscilloscope.c` 中的布局定义
2. 确认 `RIGHT_PANEL_TOP_Y` 的值
3. 检查是否有额外的padding或margin

### 临时解决方案
如果问题持续，可以手动调整Y坐标：
```c
#define RIGHT_PANEL_TOP_Y  (TOP_BAR_HEIGHT)  // 应该是40
```

---

## 编译命令

```bash
# 清理构建
idf.py fullclean

# 重新配置
idf.py reconfigure

# 编译
idf.py build

# 如果仍有问题，检查依赖
idf.py menuconfig
```

---

## 常见编译错误

### 错误1: undefined reference to `osc_draw_init`
**原因**: 链接器找不到符号
**解决**: 确保 `oscilloscope_draw.c` 被编译
```bash
# 检查CMakeLists.txt
cat BSP/GUIDER/CMakeLists.txt | grep oscilloscope
```

### 错误2: implicit declaration of function
**原因**: 缺少头文件
**解决**: 添加 `#include "oscilloscope_draw.h"`

### 错误3: PSRAM allocation failed
**原因**: PSRAM未启用或内存不足
**解决**: 
```bash
idf.py menuconfig
# Component config → ESP PSRAM → Support for external PSRAM
```

---

## 测试清单

编译成功后，测试以下功能：

- [ ] 返回按钮可点击
- [ ] 波形正常显示
- [ ] 右侧按钮位置正确
- [ ] FPS显示正常
- [ ] 无内存泄漏

---

## 如果问题仍然存在

### 方案A: 禁用硬件加速
在 `events_init.c` 中设置：
```c
static bool osc_use_hw_accel = false;  // 禁用硬件加速
```

### 方案B: 完全回退到原Chart模式
注释掉所有硬件加速相关代码，使用原来的Chart widget

### 方案C: 逐步启用
1. 先只启用10ms定时器
2. 测试稳定后再启用Sin查找表
3. 最后启用硬件加速

---

## 联系支持

如果以上方法都无法解决问题，请提供：
1. 完整的编译错误日志
2. ESP-IDF版本
3. 芯片型号
4. 内存配置
