Jackcdut/Graduation-project-ESP32/docs/OSCILLOSCOPE_CURSOR_BUILD_FIX.md

# 示波器游标功能编译修复说明

## 修复日期
2026-01-24

## 问题描述

在实现示波器游标功能后，编译时遇到两个主要问题：

### 问题1：缺少esp_dsp.h头文件

**错误信息**:
```
fatal error: esp_dsp.h: No such file or directory
   51 | #include "esp_dsp.h"
      |          ^~~~~~~~~~~
compilation terminated.
```

**原因**: GUIDER组件的CMakeLists.txt中没有包含esp-dsp组件依赖。

**解决方案**: 在`BSP/GUIDER/CMakeLists.txt`的REQUIRES列表中添加`espressif__esp-dsp`。

### 问题2：语法错误 - 函数外部的代码

**错误信息**:
```
events_init.c:4531:37: error: initializer element is not constant
 4531 |                 lv_indev_t *indev = lv_indev_get_act();
      |                                     ^~~~~~~~~~~~~~~~
events_init.c:4533:42: error: expected ')' before '&' token
 4533 |                 lv_indev_get_point(indev, &point);
      |                                          ^~
```

**原因**: 在替换Trig按钮功能时，有一段旧的trigger相关代码残留在函数外部（第4531-4603行）。

**解决方案**: 删除函数外部的残留代码。

## 修复详情

### 修复1：添加esp-dsp依赖

**文件**: `BSP/GUIDER/CMakeLists.txt`

**修改前**:
```cmake
REQUIRES lvgl__lvgl esp_wifi esp_netif main fatfs espressif__esp_lcd_touch driver esp_driver_jpeg esp_driver_ppa spiffs sdmmc esp_http_client esp_http_server json mbedtls esp_adc
```

**修改后**:
```cmake
REQUIRES lvgl__lvgl esp_wifi esp_netif main fatfs espressif__esp_lcd_touch driver esp_driver_jpeg esp_driver_ppa spiffs sdmmc esp_http_client esp_http_server json mbedtls esp_adc espressif__esp-dsp
```

### 修复2：删除残留代码

**文件**: `BSP/GUIDER/generated/events_init.c`

**删除的代码** (第4531-4603行):
```c
// 这段代码在函数外部，导致编译错误
lv_indev_t *indev = lv_indev_get_act();
lv_point_t point;
lv_indev_get_point(indev, &point);
osc_last_touch_y = point.y;
break;
}
case LV_EVENT_PRESSING:
{
    if (!osc_trigger_active || osc_trigger_line == NULL) break;
    // ... 更多trigger相关代码 ...
}
case LV_EVENT_RELEASED:
{
    osc_last_touch_y = 0;
    break;
}
default:
    break;
}
}
```

这段代码是旧的trigger功能的残留，应该在替换为游标功能时被完全删除。

## 编译验证

修复后，编译应该成功通过：

```bash
idf.py build
```

**预期结果**:
- ✅ 无编译错误
- ✅ 仅有警告（未使用的变量等，不影响功能）
- ✅ 成功生成固件

## 警告说明

编译过程中可能会出现一些警告，这些是正常的：

### 1. 未使用的变量警告
```
warning: unused variable 'xxx' [-Wunused-variable]
```
这些是代码中定义但未使用的变量，不影响功能。

### 2. 函数类型转换警告
```
warning: cast between incompatible function types [-Wcast-function-type]
```
这是LVGL动画回调函数的类型转换，是LVGL库的正常用法。

### 3. 未使用的函数警告
```
warning: 'xxx' defined but not used [-Wunused-function]
```
这些是预留的功能函数，暂时未被调用。

## 测试建议

修复后，建议进行以下测试：

1. **编译测试**
   ```bash
   idf.py build
   ```
   确认编译成功，无错误。

2. **烧录测试**
   ```bash
   idf.py flash
   ```
   确认固件可以正常烧录。

3. **功能测试**
   - 启动设备
   - 进入示波器界面
   - 点击"Cursor"按钮
   - 验证游标功能正常工作

## 相关文件

- `BSP/GUIDER/CMakeLists.txt` - 组件依赖配置
- `BSP/GUIDER/generated/events_init.c` - 事件处理代码
- `docs/OSCILLOSCOPE_CURSOR_MEASUREMENT.md` - 功能说明
- `docs/OSCILLOSCOPE_CURSOR_QUICK_TEST.md` - 测试指南

## 总结

两个编译问题都已成功修复：

1. ✅ 添加了esp-dsp组件依赖
2. ✅ 删除了函数外部的残留代码

现在代码可以正常编译，游标功能可以正常使用。

## 后续注意事项

1. **保持依赖同步**: 如果使用了新的ESP-IDF组件，记得在CMakeLists.txt中添加依赖。

2. **代码清理**: 在替换功能时，确保完全删除旧代码，避免残留。

3. **编译验证**: 每次修改后都应该编译验证，及时发现问题。

4. **版本控制**: 使用git等版本控制工具，方便回退和对比。
