Jackcdut/Graduation-project-ESP32/软件设计/调试记录.docx

使用全屏双缓冲并将SRAM移动到PSRAM中 ---- 能够最大程度防止撕裂，但同时帧率会下降，因为PSRAM时钟最大200M，而主控360MHZ。
