Jackcdut/Graduation-project-ESP32/硬件设计/产品资料/SCH_Schematic1_2025-12-11.pdf

## 信号发生器

## 通过DDS产生

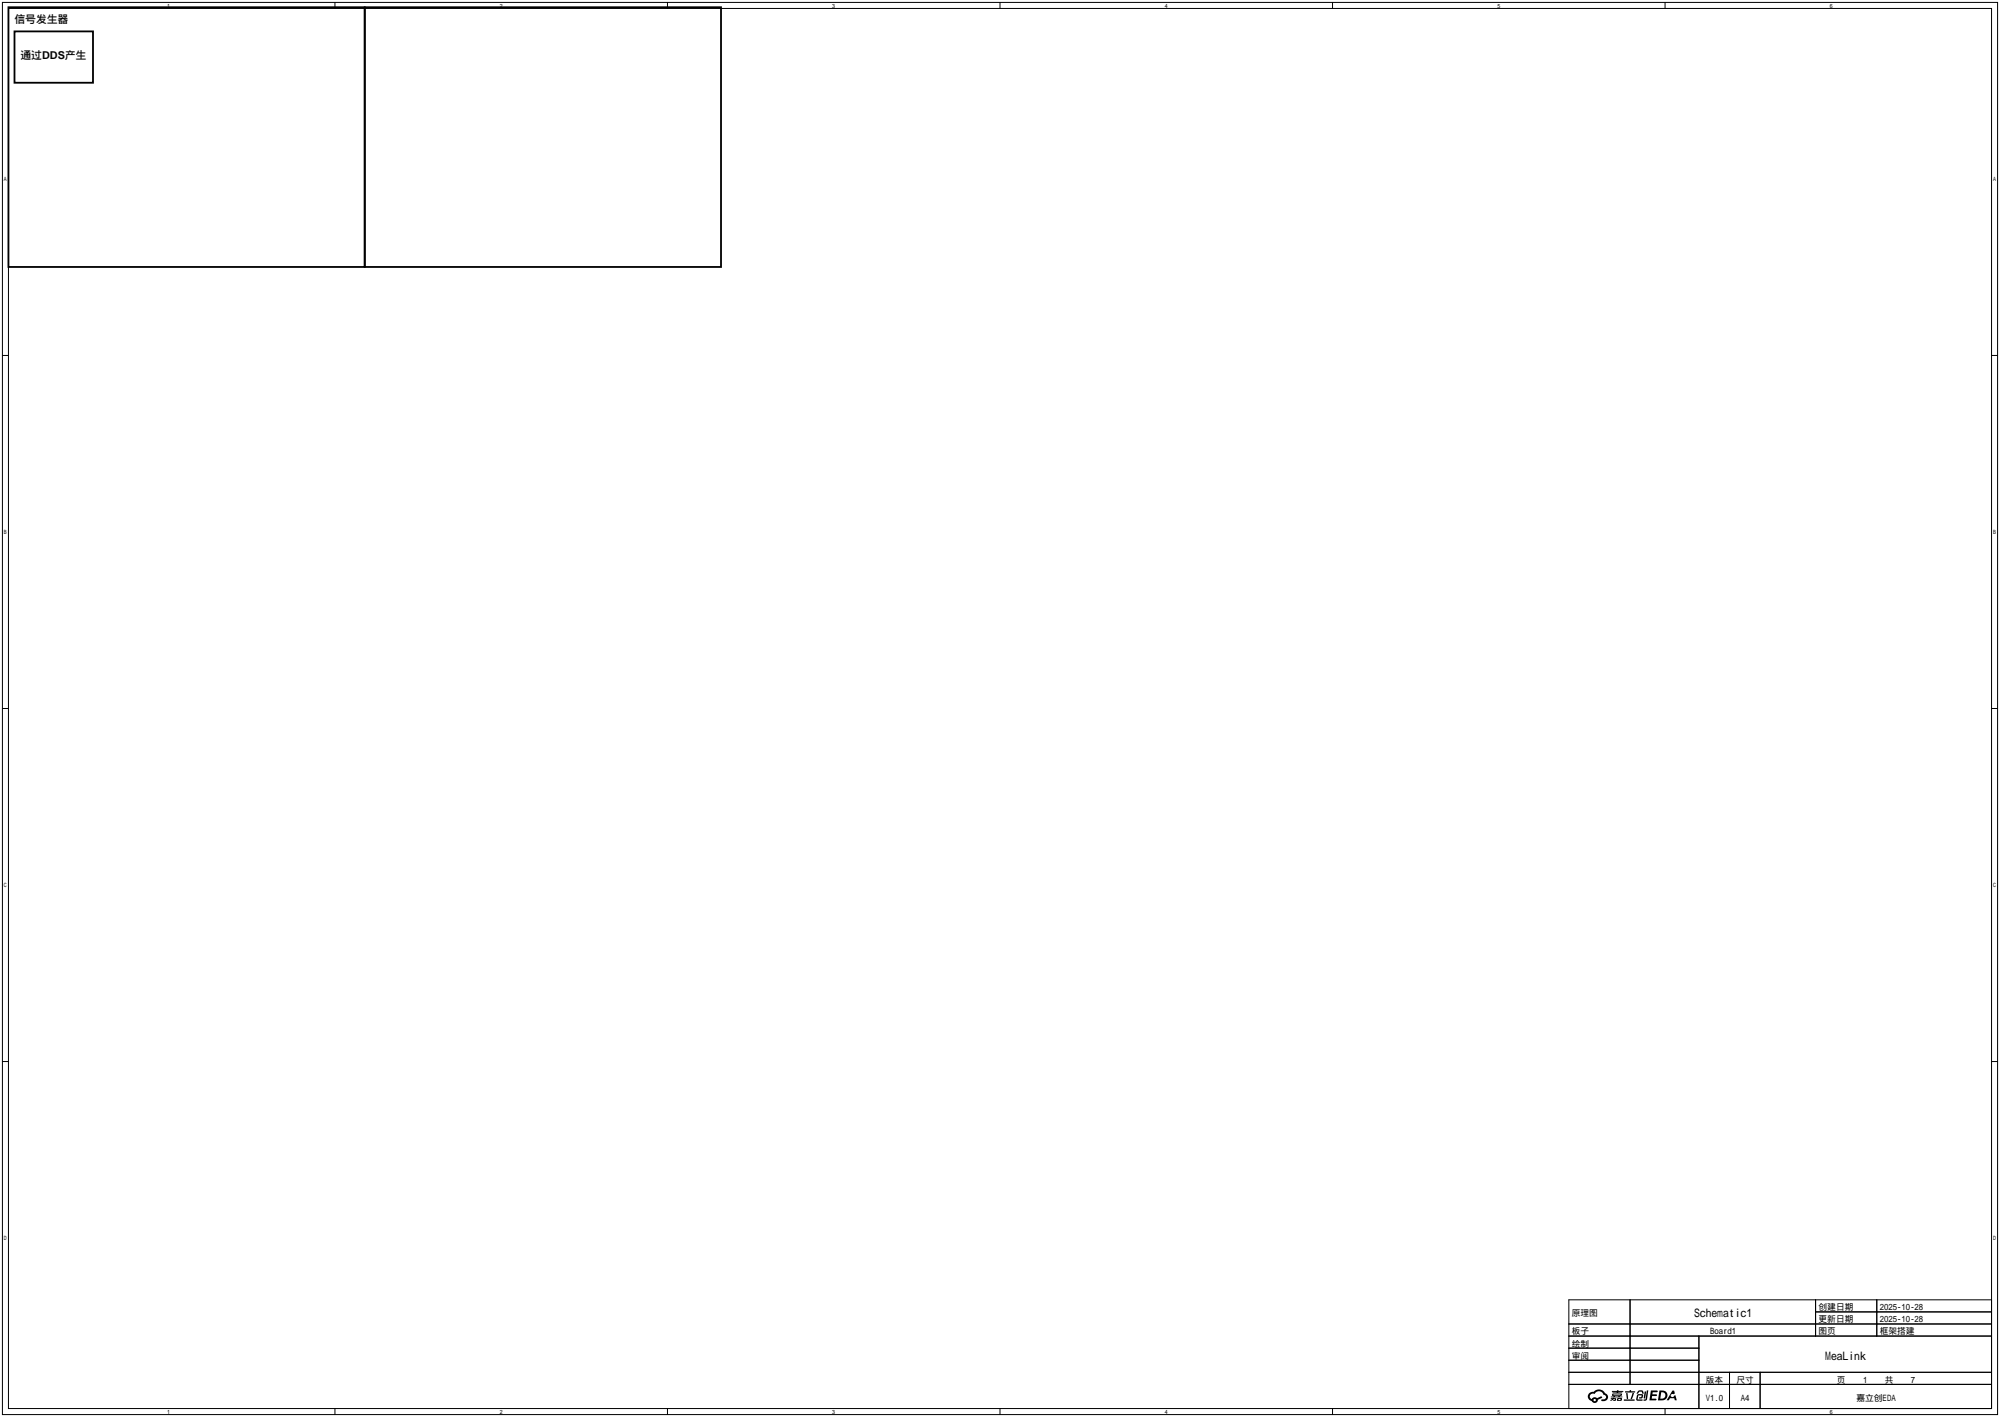
[picture p69: page 1]

原理图 | Schematic1 | 创建日期 | 2025-10-28

更新日期 | 2025-10-28

板子 | Board1 | 图页 | 框架搭建
绘制 | | MeaLink
审阅

V1.0 | A4 | 嘉立创EDA

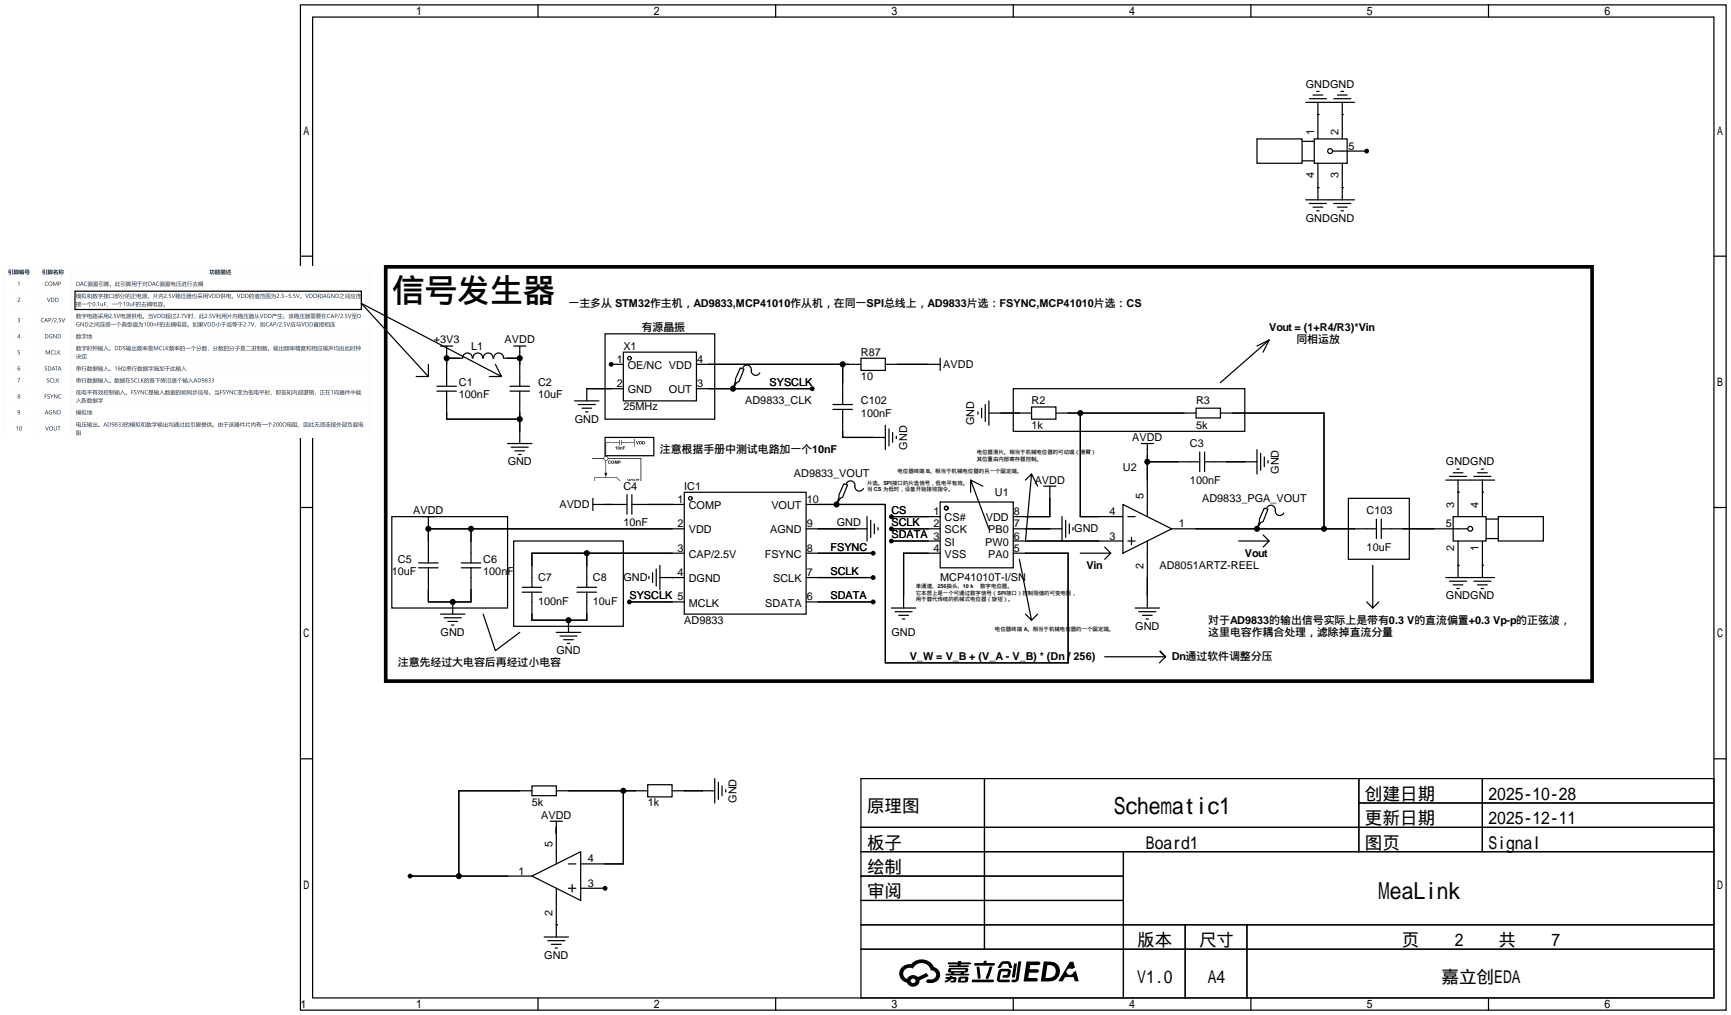
[picture p70: page 2]

一主多从 STM32作主机，AD9833,MCP41010作从机，在同一SPI总线上，AD9833片选：FSYNC,MCP41010片选：CS

原理图 | Schematic1 | 创建日期 | 2025-10-28

更新日期 | 2025-12-11

板子 | Board1 | 图页 | Signal
绘制 | | MeaLink
审阅

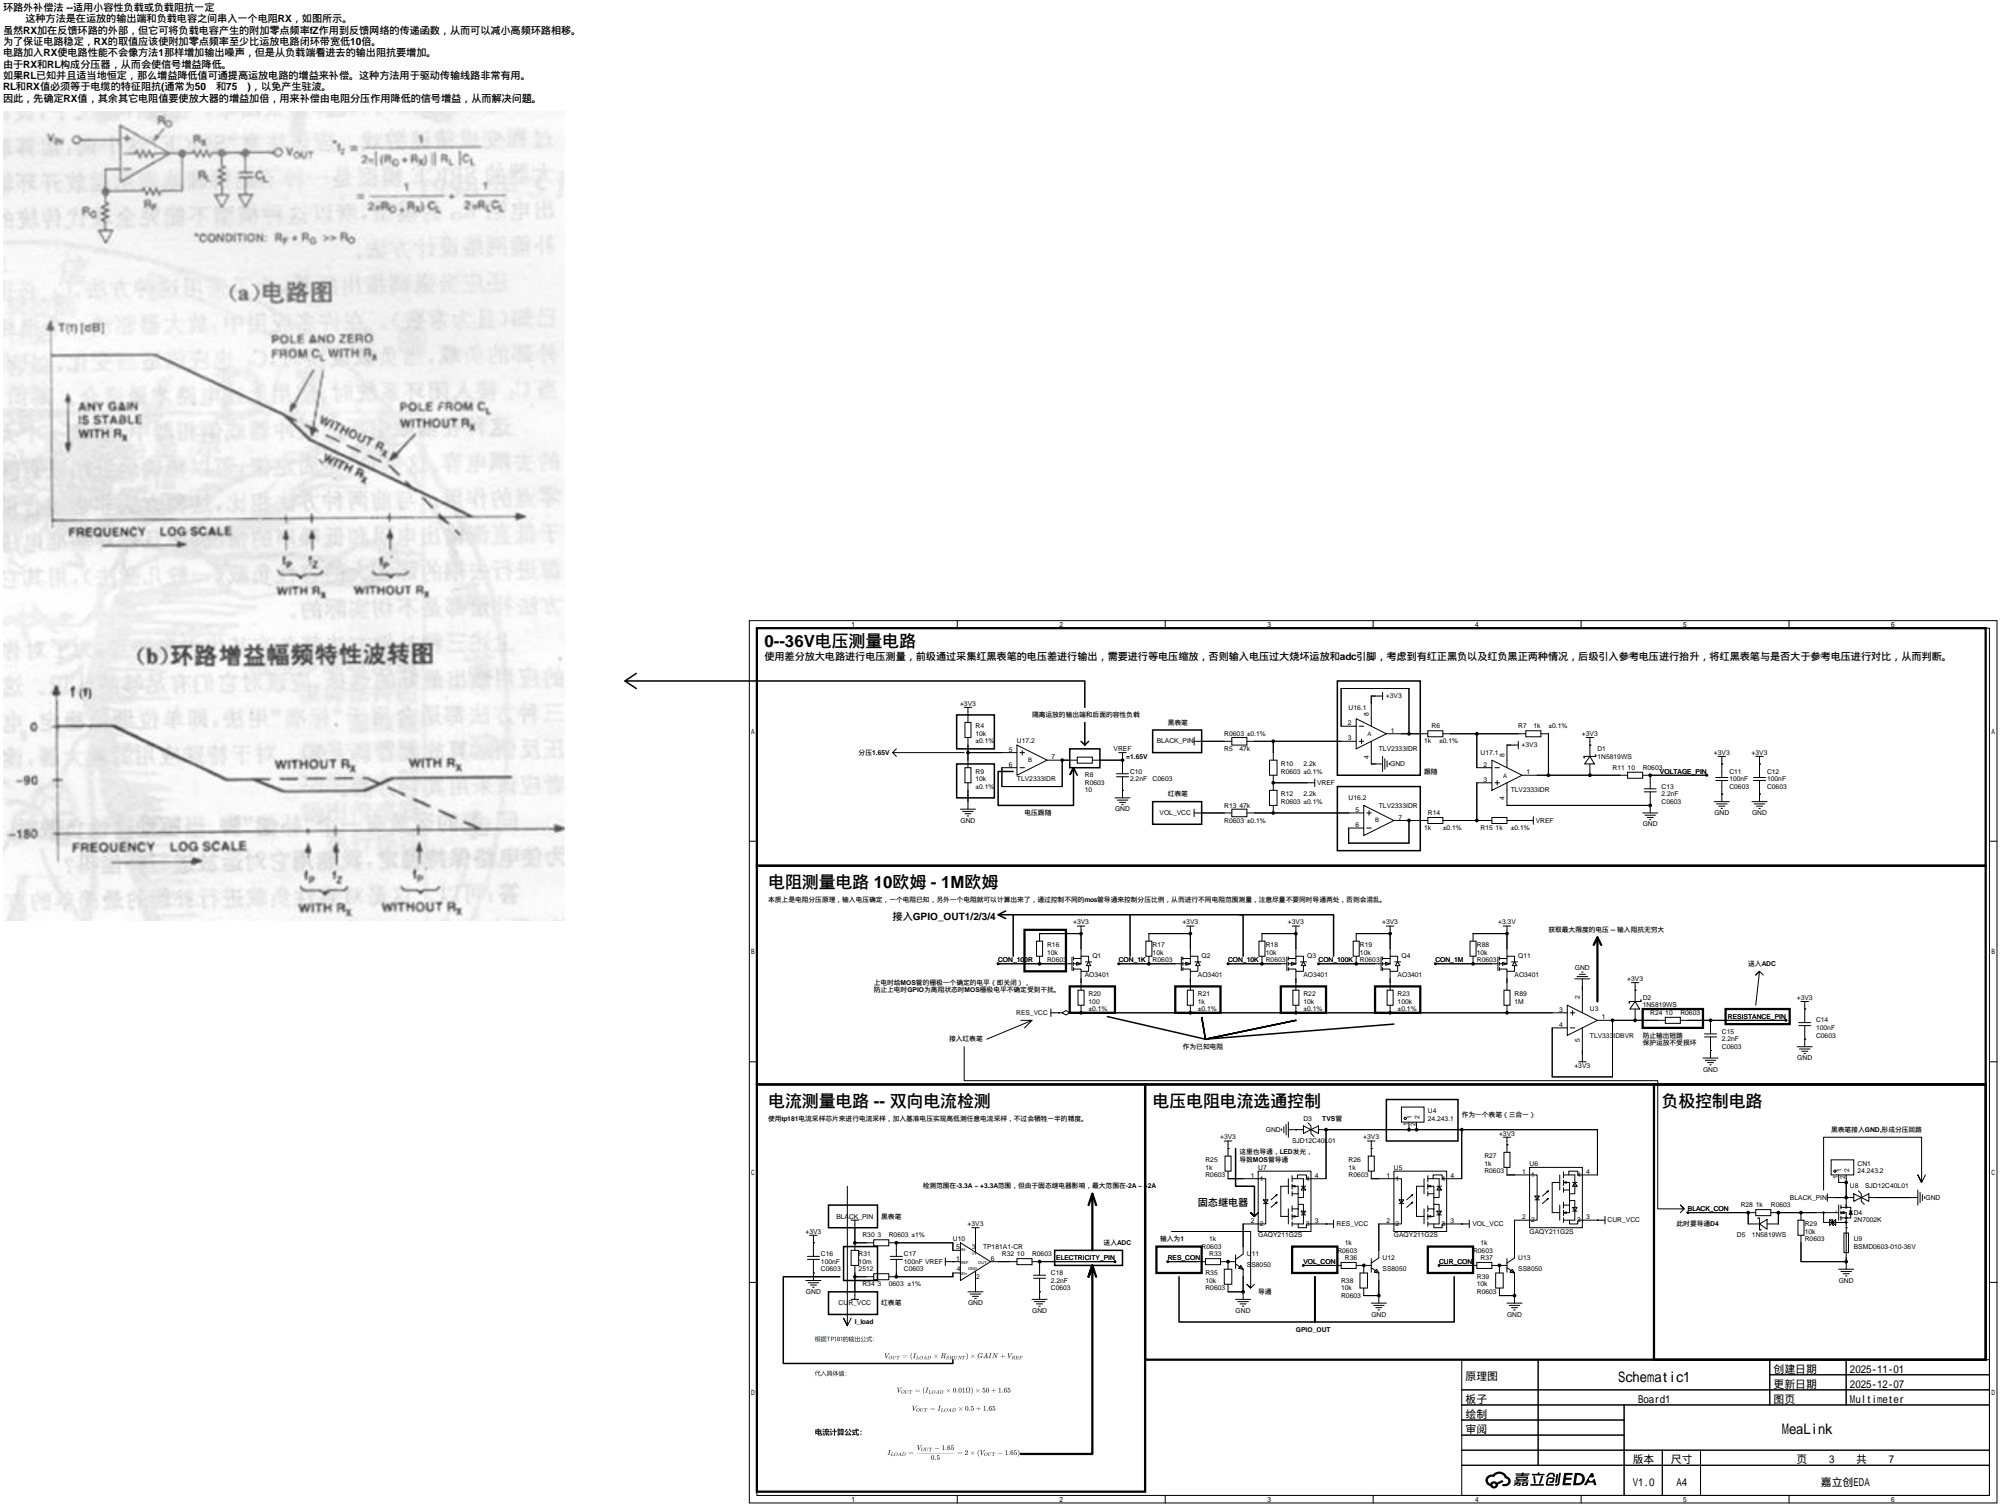
[picture p71: page 3]

环路外补偿法 --适用小容性负载或负载阻抗一定
这种方法是在运放的输出端和负载电容之间串入一个电阻RX，如图所示。
虽然RX加在反馈环路的外部，但它可将负载电容产生的附加零点频率fZ作用到反馈网络的传递函数，从而可以减小高频环路相移。
为了保证电路稳定，RX的取值应该使附加零点频率至少比运放电路闭环带宽低10倍。
电路加入RX使电路性能不会像方法1那样增加输出噪声，但是从负载端看进去的输出阻抗要增加。
由于RX和RL构成分压器，从而会使信号增益降低。
如果RL已知并且适当地恒定，那么增益降低值可通提高运放电路的增益来补偿。这种方法用于驱动传输线路非常有用。
RL和RX值必须等于电缆的特征阻抗(通常为50Ω和75 )，以免产生驻波。
因此，先确定RX值，其余其它电阻值要使放大器的增益加倍，用来补偿由电阻分压作用降低的信号增益，从而解决问题。

使用差分放大电路进行电压测量，前级通过采集红黑表笔的电压差进行输出，需要进行等电压缩放，否则输入电压过大烧坏运放和adc引脚，考虑到有红正黑负以及红负黑正两种情况，后级引入参考电压进行抬升，将红黑表笔与是否大于参考电压进行对比，从而判断。

本质上是电阻分压原理，输入电压确定，一个电阻已知，另外一个电阻就可以计算出来了，通过控制不同的mos管导通来控制分压比例，从而进行不同电阻范围测量，注意尽量不要同时导通两处，否则会混乱。

原理图 | Schematic1 | 创建日期 | 2025-11-01

更新日期 | 2025-12-07

板子 | Board1 | 图页 | Multimeter
绘制 | | MeaLink
审阅

# PD7 123 PD6 122 PD5 119 PD4 118 PD3 117 PD2 116 PD1 115 PD0 114

# PE15 68 PE14 67 PE13 66 PE12 65 PE11 64 PE10 63 PE9 60 PE8 59

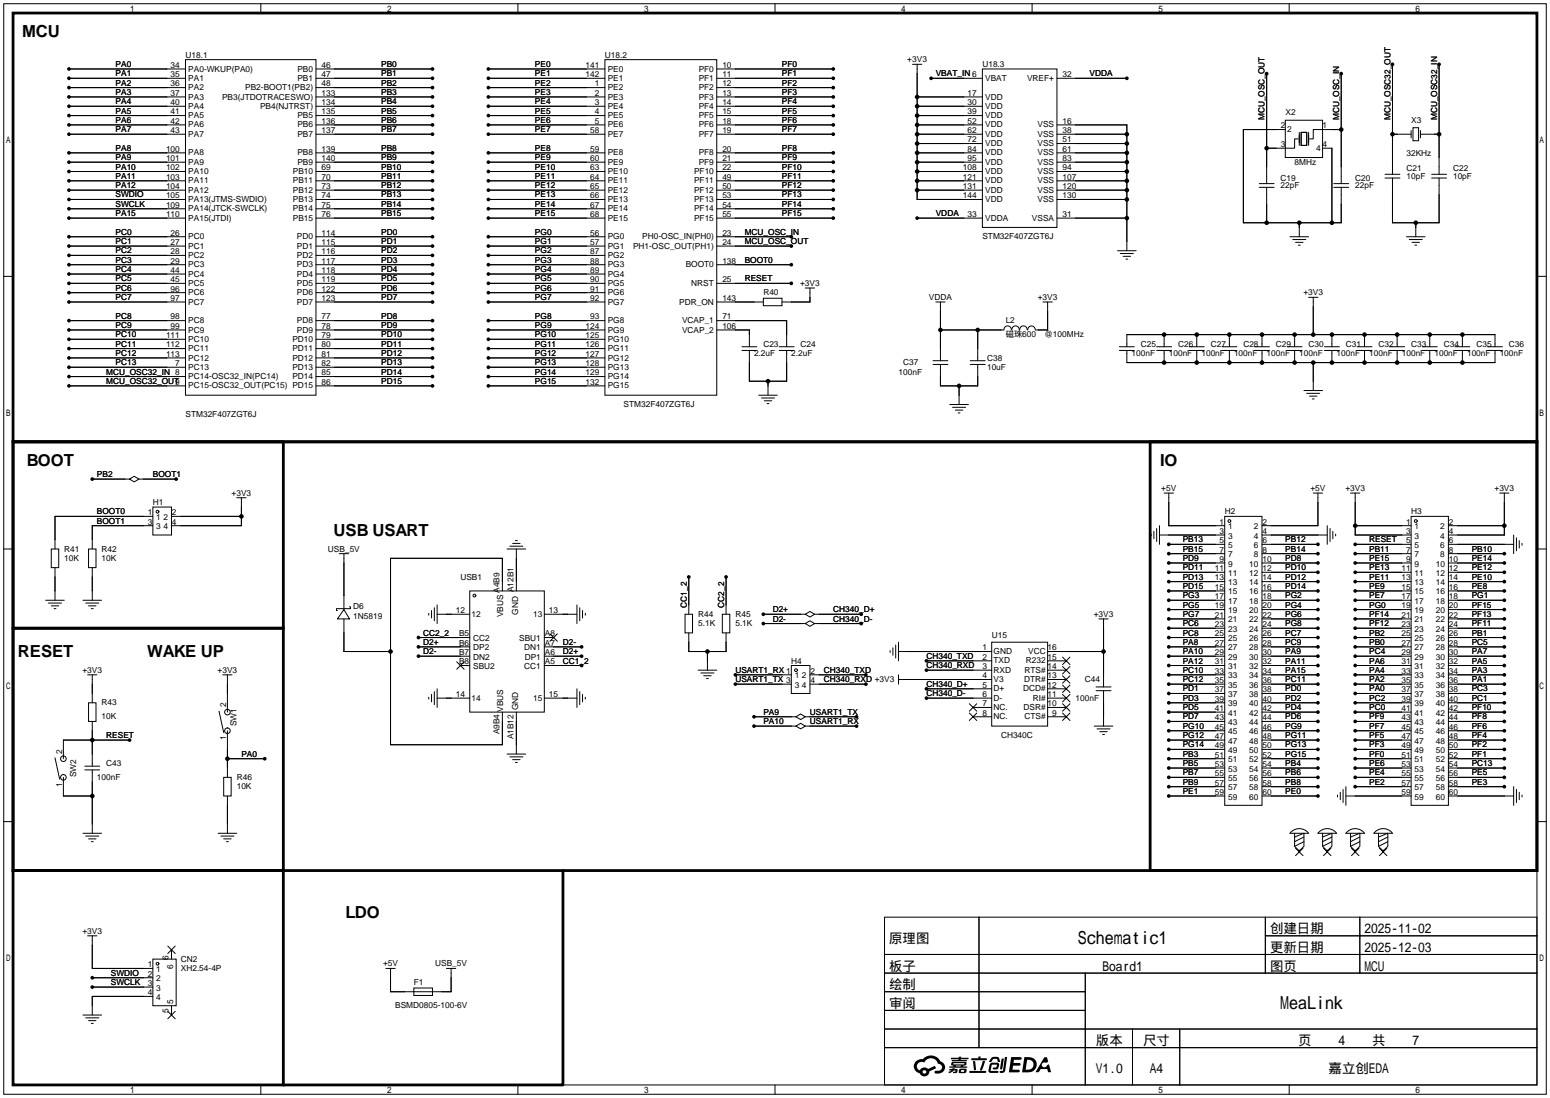
[picture p72: page 4]

PA15(JTDI) 110 PA14(JTCK-SWCLK) 109 PA13(JTMS-SWDIO) 105 PA12 104 PA11 103 PA10 102 PA9 101 PA8 100

原理图 | Schematic1 | 创建日期 | 2025-11-02

更新日期 | 2025-12-03

板子 | Board1 | 图页 | MCU
绘制 | | MeaLink
审阅

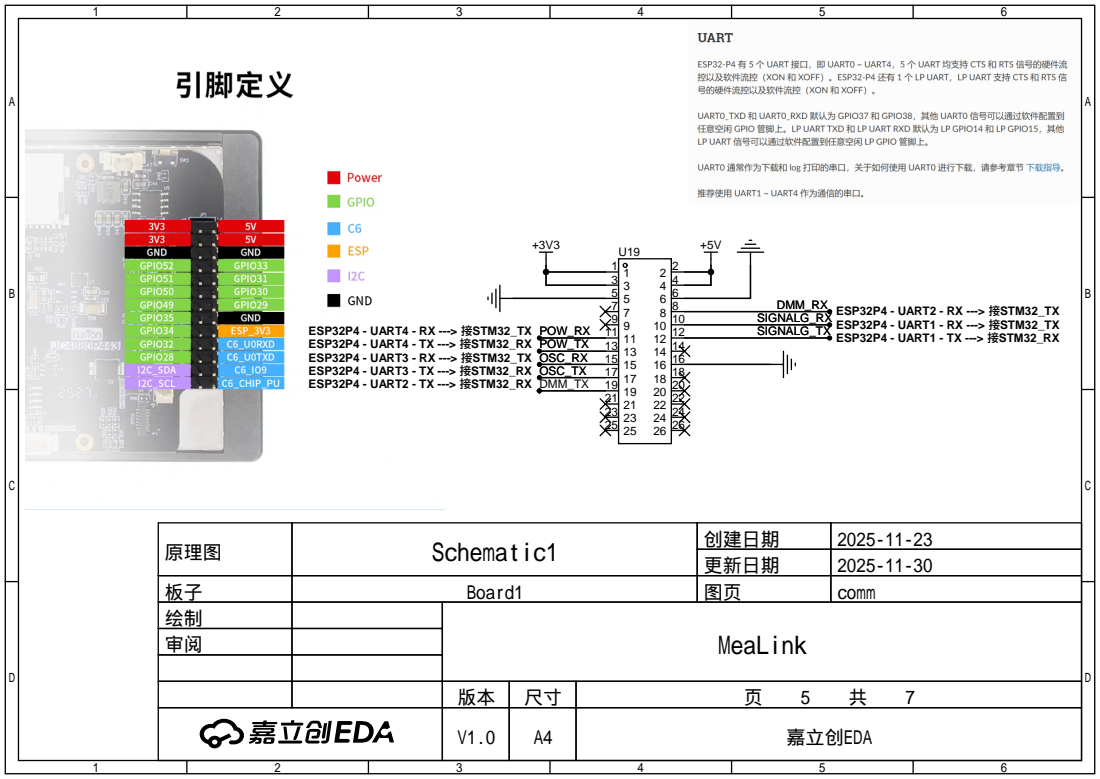
[picture p73: page 5]

原理图 | Schematic1 | 创建日期 | 2025-11-23

更新日期 | 2025-11-30

板子 | Board1 | 图页 | comm
绘制 | | MeaLink
审阅

# DCDC 升降压

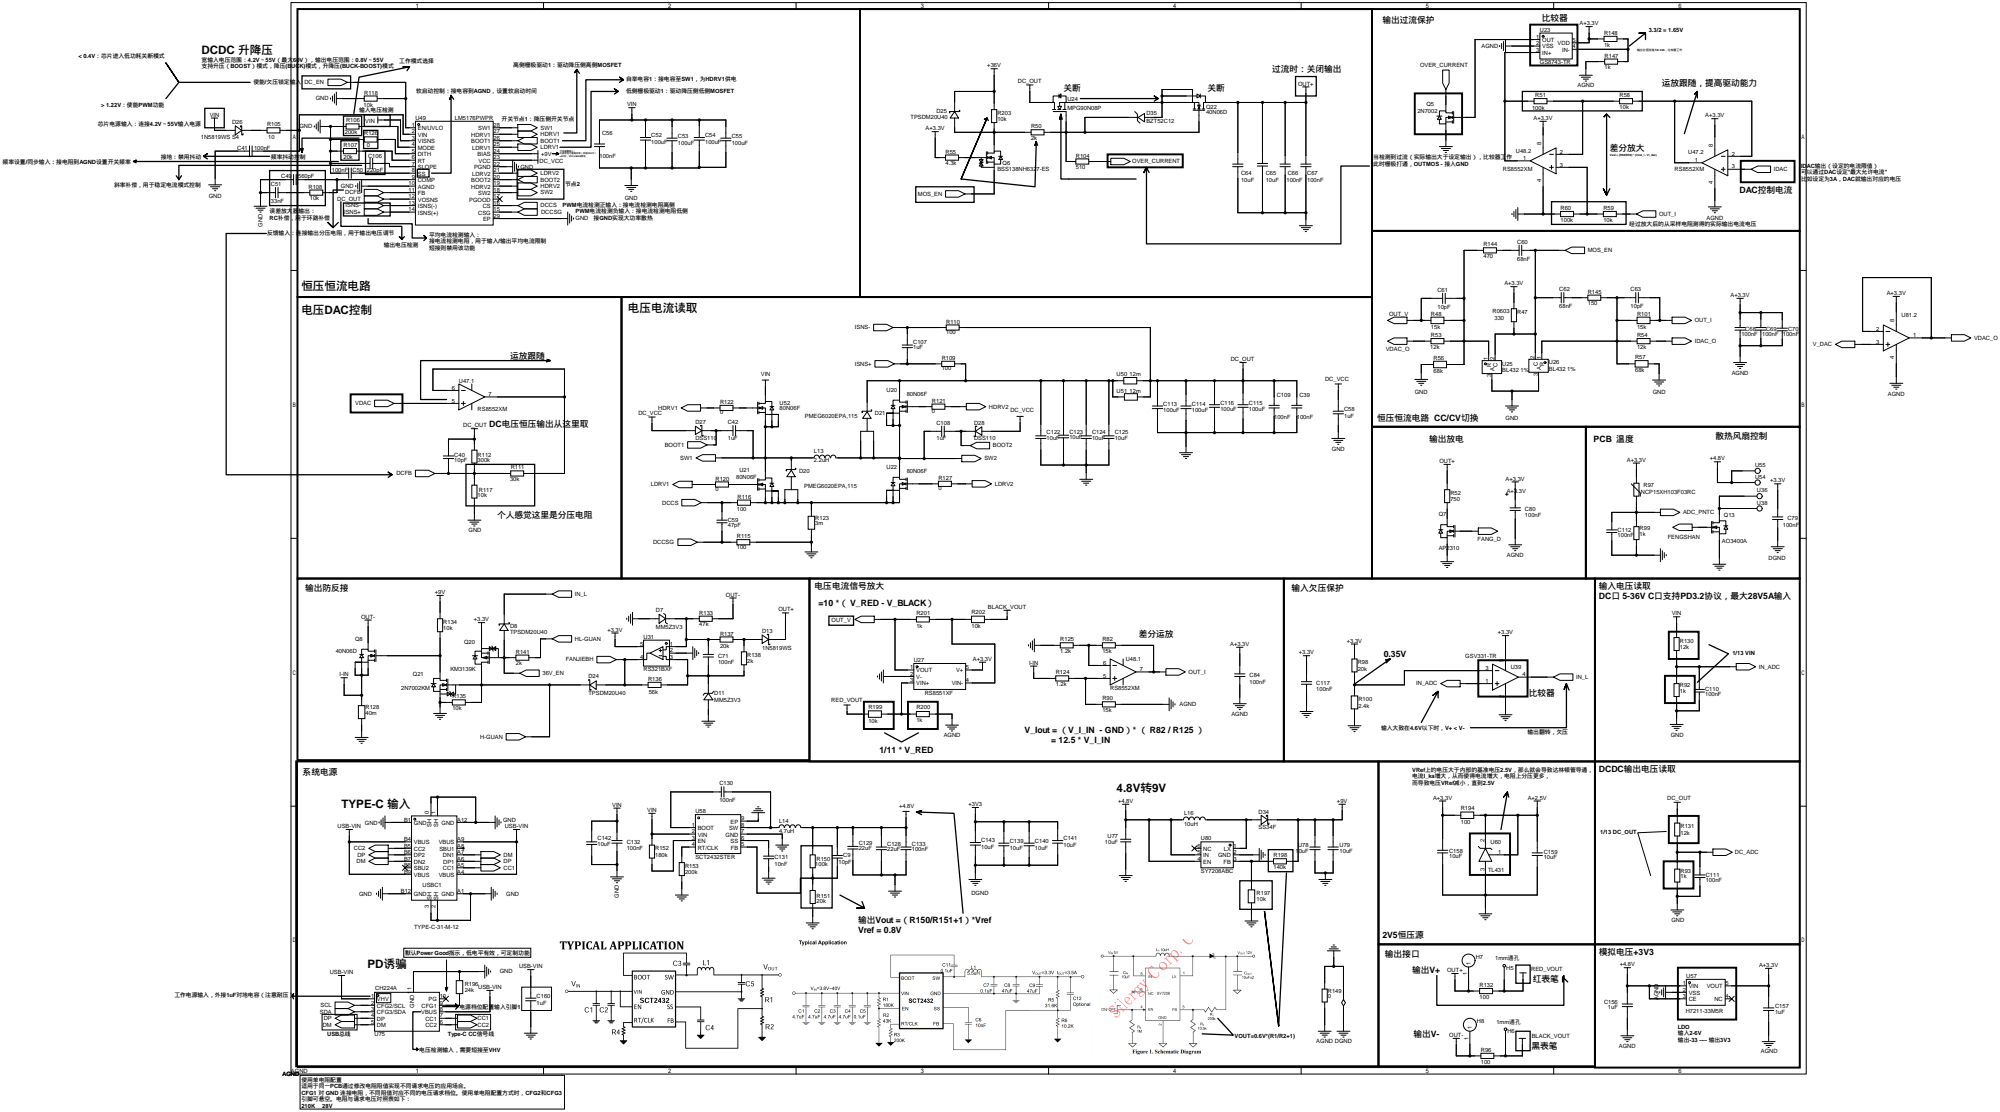
[picture p74: page 6]

宽输入电压范围：4.2V～55V（最大60V），输出电压范围：0.8V～55V
支持升压（BOOST）模式，降压(BUCK)模式，升降压(BUCK-BOOST)模式

默认Power Good指示，低电平有效，可定制功能
PD诱骗

# 前端处理电路

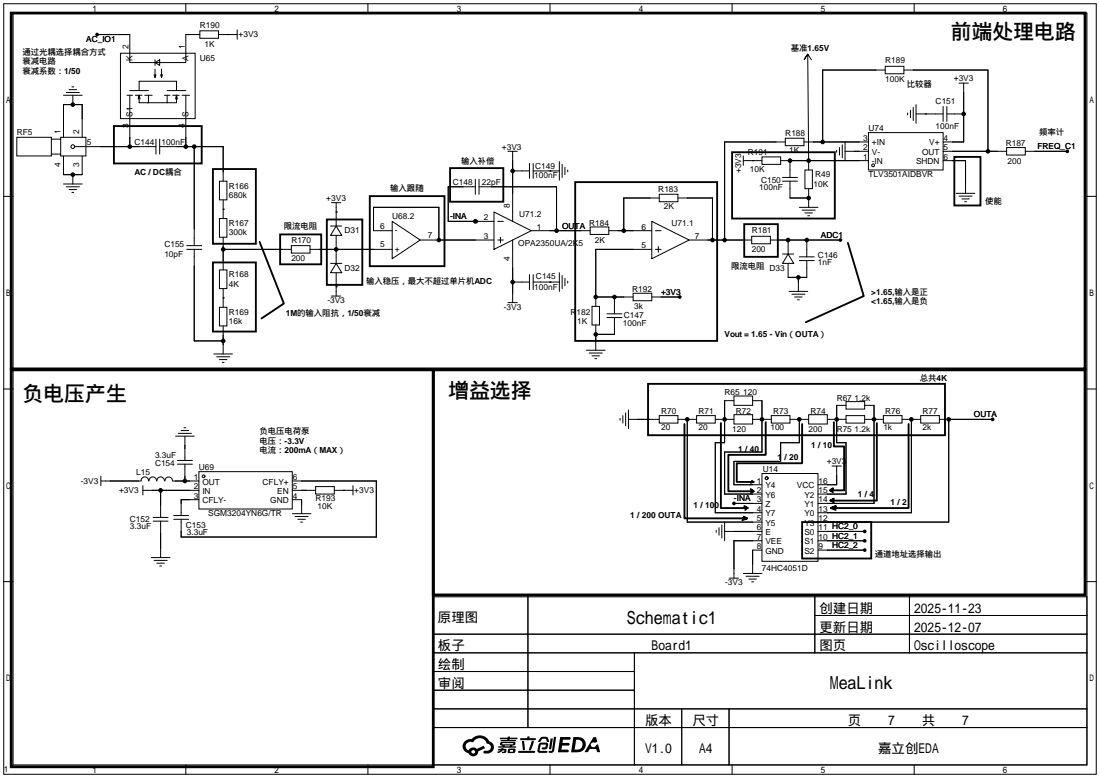
[picture p75: page 7]

原理图 | Schematic1 | 创建日期 | 2025-11-23

更新日期 | 2025-12-07

板子 | Board1 | 图页 | Oscilloscope
绘制 | | MeaLink
审阅
