Jackcdut/Graduation-project-ESP32/(list of files, drawings)

Other design files:
硬件设计/模板工程/STLINK1.eprj
硬件设计/模板工程/万用表.eprj
硬件设计/模板工程/信号发生器.eprj
硬件设计/模板工程/数控电源.eprj
硬件设计/模板工程/数控电源_V3.eprj
硬件设计/模板工程/示波器_V2.eprj
