Jackcdut/Graduation-project-ESP32/stm32/Core/Src/main.c

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
/* Includes ------------------------------------------------------------------*/
#include "main.h"
#include "adc.h"
#include "dac.h"
#include "dma.h"
#include "spi.h"
#include "tim.h"
#include "usart.h"
#include "gpio.h"

/* USER CODE BEGIN Includes */
#include "signal_generator.h"
#include "multimeter.h"
#include "uart_comm.h"
#include "cmd_handler.h"
#include "data_reporter.h"
#include "power_supply.h"
/* USER CODE END Includes */


void SystemClock_Config(void);
/**
  * @brief  The application entry point.
  * @retval int
  */
int main(void)
{

  /* MCU Configuration--------------------------------------------------------*/

  /* Reset of all peripherals, Initializes the Flash interface and the Systick. */
  HAL_Init();

  /* Configure the system clock */
  SystemClock_Config();

  /* Initialize all configured peripherals */
  MX_GPIO_Init();
  MX_DMA_Init();
  MX_SPI2_Init();
  MX_ADC1_Init();
  MX_USART1_UART_Init();
  MX_ADC2_Init();
  MX_ADC3_Init();
  MX_TIM2_Init();
  MX_SPI1_Init();
  MX_DAC_Init();
  /* USER CODE BEGIN 2 */
  /* 信号发生器初始化 */
  SignalGenerator_Init();
  SignalGenerator_SetOutput(100000, WAVE_SINE, 1.0f);
  
  /* 万用表初始化 */
  Multimeter_Init();
  Multimeter_StartADC();
  
  /* 数控电源初始化 */
  PowerSupply_Init();
  
  /* 通信模块初始化 */
  UartComm_Init();          /* UART DMA通信初始化 */
  CmdHandler_Init();        /* 命令处理模块初始化 */
  DataReporter_Init();      /* 数据上报模块初始化 */
  
  /* 设置默认工作模式为空闲模式，等待ESP32发送模式切换命令 */
  DataReporter_SetMode(REPORTER_MODE_IDLE);
  /* USER CODE END 2 */

  /* Infinite loop */
  /* USER CODE BEGIN WHILE */
  while (1)
  {
    /* 通信模块周期处理 */
    UartComm_Process();     /* 处理接收到的数据帧 */
    DataReporter_Process(); /* 定时发送测量数据 */
    
    /* 数控电源周期处理 (ADC采样、保护检测等) */
    PowerSupply_Process();
    
    /* USER CODE END WHILE */

    /* USER CODE BEGIN 3 */
  }
  /* USER CODE END 3 */
}

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
