Jackcdut/Graduation-project-ESP32/(commit log)

2026-01-17 Initial commit: ESP32-P4 Multi-function Development Board V1.0
    - Complete ESP32-P4 + ESP32-C6 dual-chip architecture
    - Full-screen double buffering display system (LVGL v8.3)
    - Network communication modules (WiFi, OneNET, Weather API)
    - 11 GUI screens with custom modules
    - Oscilloscope, wireless serial, screenshot features
    - Web dashboard with data visualization
    - Performance optimization (100 FPS, dual-core parallel)
    - Complete documentation system
    [partitions.csv]
2026-01-17 Reorganize repository with folder-based version management (V1.0)
    [partitions.csv]
2026-01-17 Add V2.0 development version based on V1.0
    [partitions.csv]
2026-01-17 V2.0 版本更新
    - 完善无线串口功能，现在能够正常使用
    - 优化视频播放，能够正常播放视频但会出现些许卡顿
2026-01-17 添加 V2.0 版本说明文档
2026-01-17 更新根目录 README.md，添加 V2.0 版本详细说明
2026-01-24 Release V3.0: 完善示波器功能，支持FFT频谱分析和数据导出
    主要更新：
    - 示波器功能全面优化和完善
    - 新增FFT频谱分析功能，支持实时频谱显示和谐波分析
    - 新增数据导出功能，支持波形数据和FFT数据导出为CSV格式
    - 示波器相关页面进一步美化和优化
    - 使用ESP32-P4内置ADC作为采样源进行波形显示测试
    - 改进波形测量算法，提高精度
    - 优化数据采集和处理流程
    - 模块化代码架构，易于维护和扩展
    [partitions.csv]
2026-01-25 V4.0: UI优化与云平台管理改进
    主要更新:
    1. 美化电源页面和设置页面UI
    2. 优化数控电源页面控制逻辑
    3. 更换About界面显示内容
    4. 将云平台管理页面改为未激活状态
    5. 启用QR Code组件(CONFIG_LV_USE_QRCODE=y)，WiFi和URL以二维码显示
    [partitions.csv]
2026-01-25 更新README: 添加V4.0版本说明
2026-01-31 V1.0: 重构项目结构，整合ESP32-P4+ESP32-C6+STM32三芯片架构
    - 删除旧版本文件夹(V1.0-V4.0)，将项目扁平化
    - 新增STM32F407固件代码，实现示波器/万用表/信号发生器/数控电源功能
    - 完善ESP32与STM32通信协议
    - 更新README文档，反映完整项目架构
    - 优化.gitignore配置
    功能模块:
    - 示波器: 双通道ADC采样，FFT频谱分析
    - 数控电源: CC/CV模式，PD快充输入
    - 万用表: 电压/电流/电阻测量
    - 信号发生器: DDS波形输出
    - 云平台: OneNET物联网集成
    - Web仪表盘: 实时数据可视化
    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
    [partitions.csv]
2026-01-31 🎉 初始化毕业设计仓库
    - 添加项目README和LICENSE
    - 添加任务书、选题思路、信息文档
    - 添加毕业论文相关资料（开题报告、文献翻译、参考文献）
    - 添加硬件设计资料（原理图、芯片手册、模板工程）
    - 添加软件设计调试记录
    - 配置.gitignore忽略规则
    [STLINK1.eprj, 万用表.eprj, 信号发生器.eprj, 数控电源.eprj, 数控电源_V3.eprj, 示波器_V2.eprj]
2026-01-31 docs: 更新README添加分支导航
    - 添加分支结构表格，指向各内容分支
    - 简化项目介绍，突出分支管理方式
    - 添加快速开始指南
