Jackcdut/Graduation-project-ESP32/(notices)

Notices in the files:
stm32/Core/Src/main.c:
Copyright (c) 2025 STMicroelectronics.
All rights reserved.
This software is licensed under terms that can be found in the LICENSE file
stm32/Core/Src/adc.c:
Copyright (c) 2026 STMicroelectronics.
